SimeonSimeonovIvanov/ROBKO-01/doc/SNS_2009/SNS_2009_ROBKO_Cv_De_Si_04_09_ppt.pdf

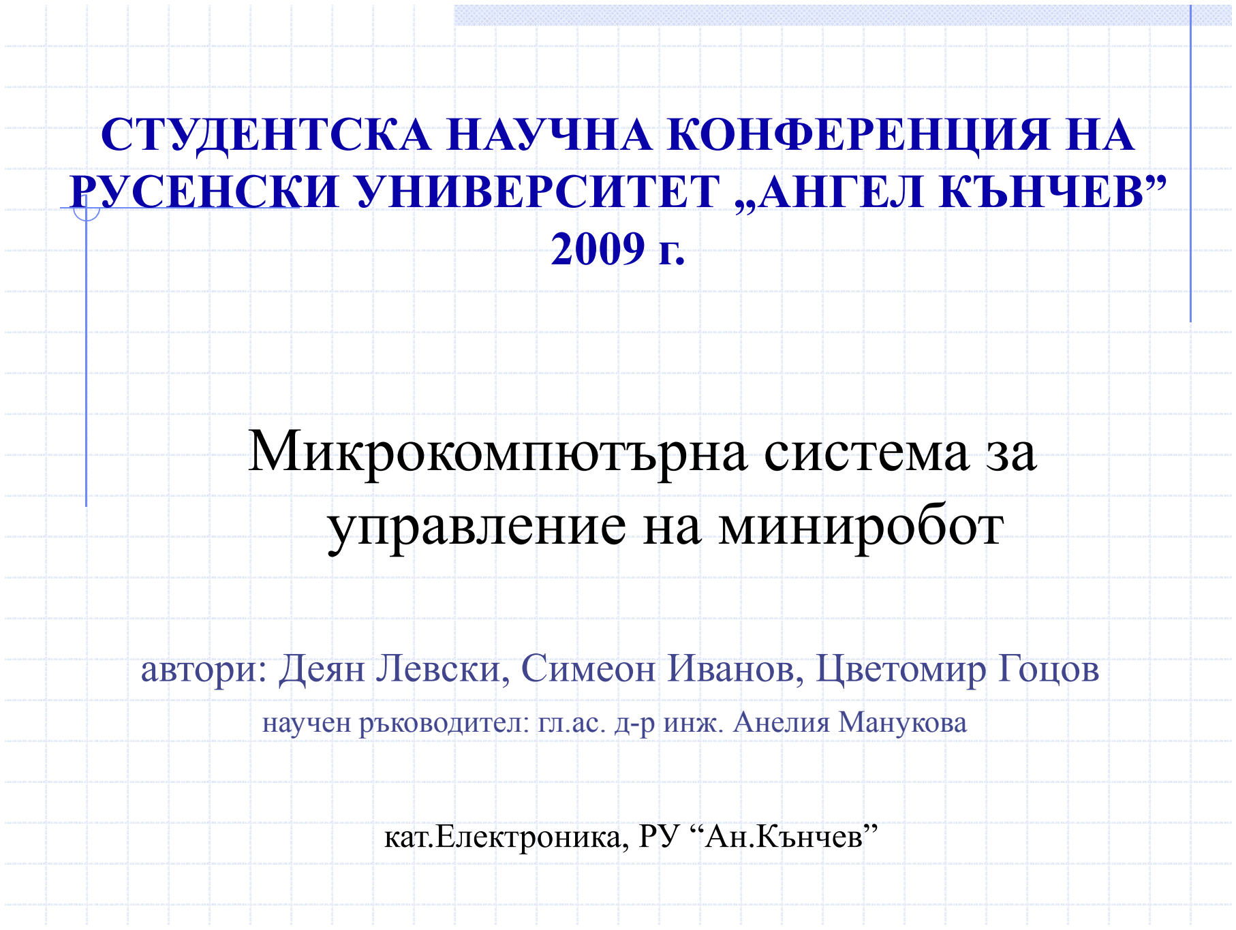
[picture p27: figure]
Микрокомпютърна система за управление на миниробот; кат.Електроника, РУ “Ан.Кънчев”; СТУДЕНТСКА НАУЧНА КОНФЕРЕНЦИЯ НА РУСЕНСКИ УНИВЕРСИТЕТ „АНГЕЛ КЪНЧЕВ” 2009 г.

## автори: Деян Левски, Симеон Иванов, Цветомир Гоцов

научен ръководител: гл.ас. д-р инж. Анелия Манукова

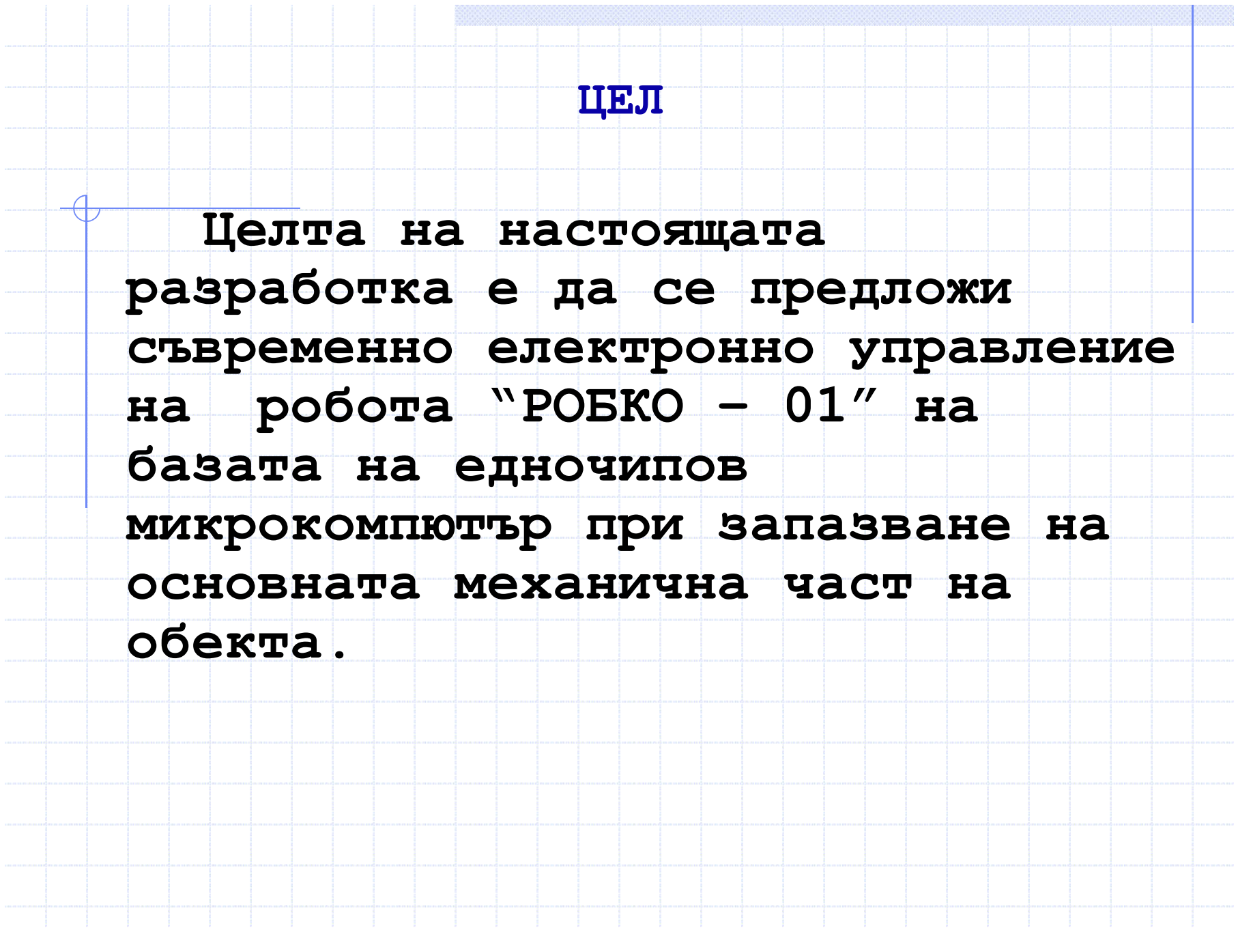
[picture p28: figure]
Целта на настоящата разработка е да се предложи съвременно електронно управление; робота “РОБКО – 01” на; базата на едночипов микрокомпютър при запазване на основната механична част на обекта.; ЦЕЛ

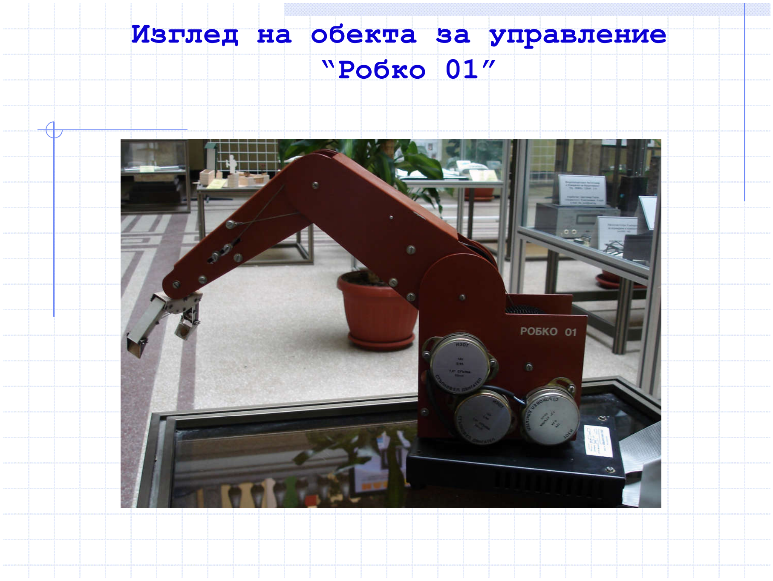
[picture p29: figure]
Изглед на обекта за управление “Робко 01”

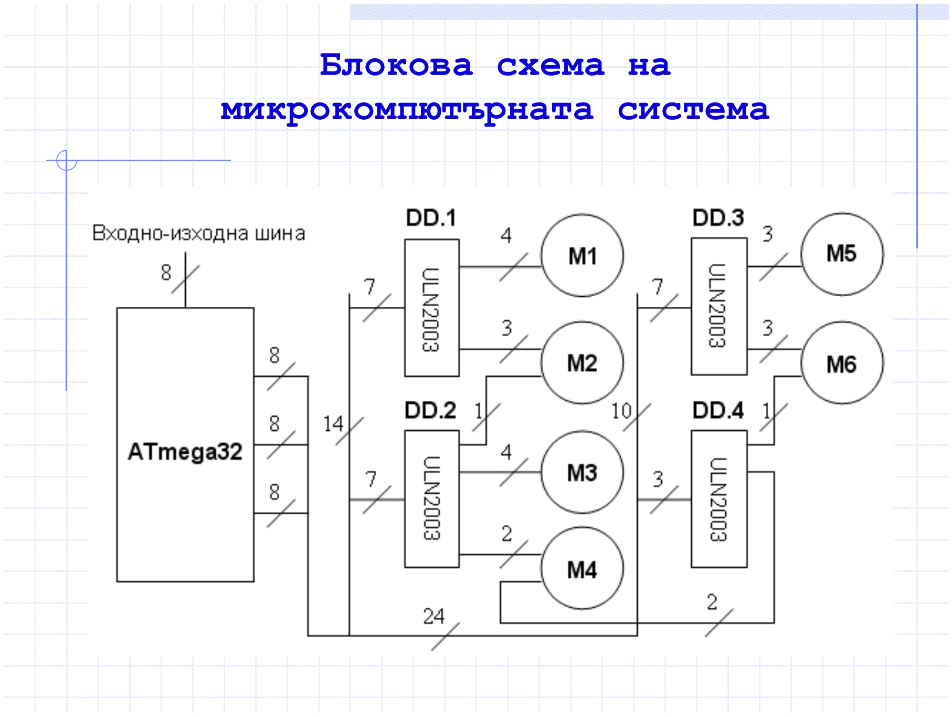
[picture p30: figure]
Блокова схема на микрокомпютърната система

## Алгоритъм за управление на

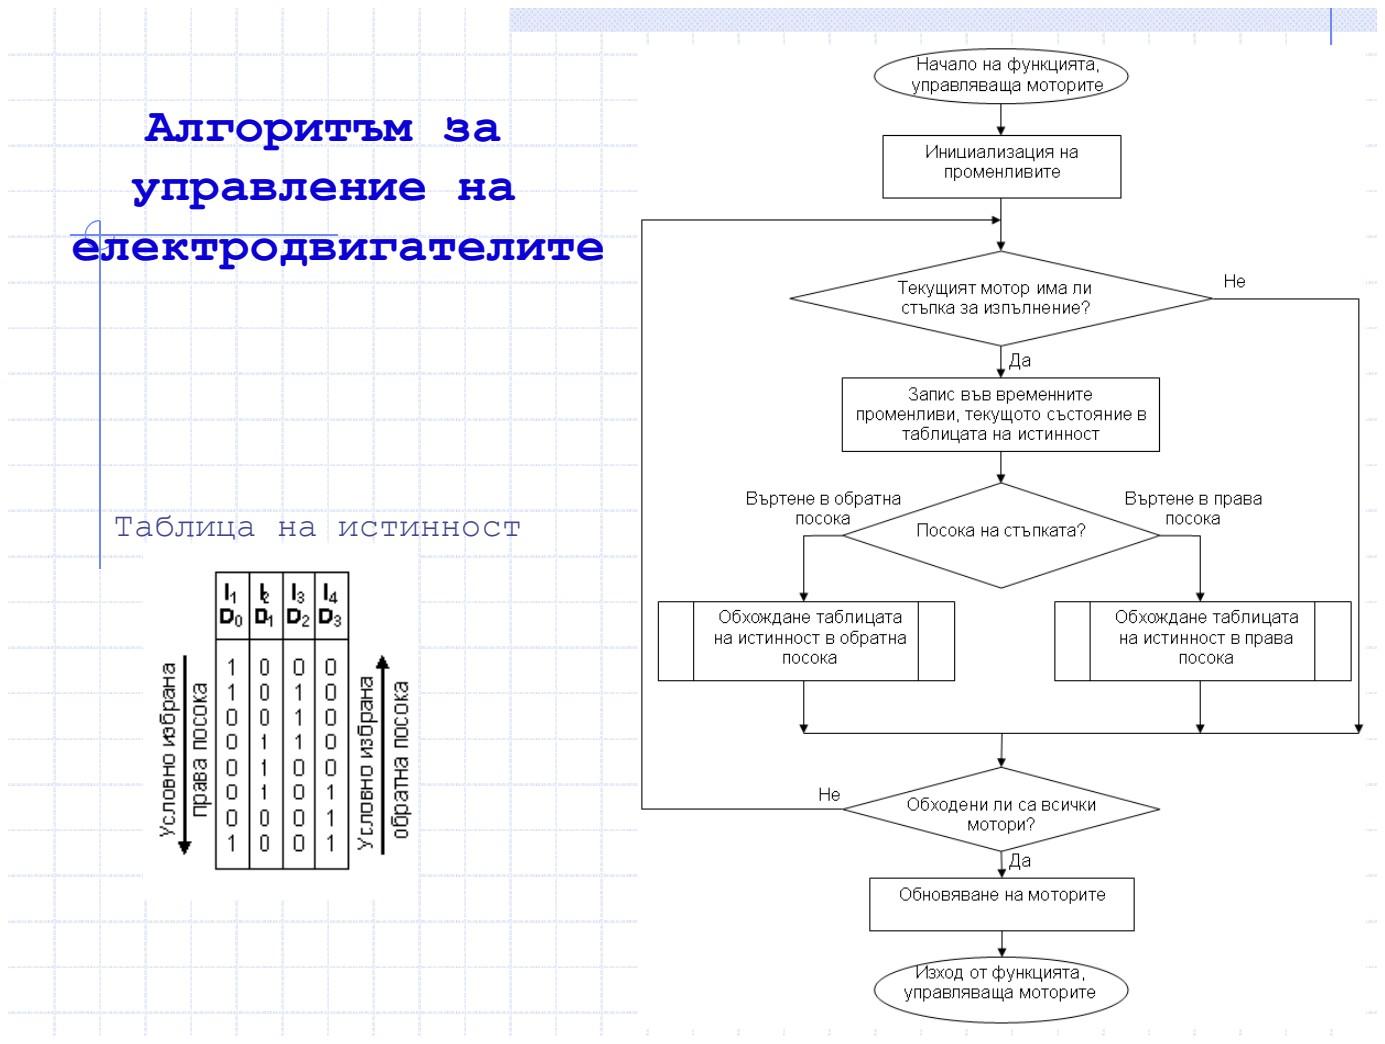
[picture p31: page 5]

## електродвигателите

Таблица на истинност

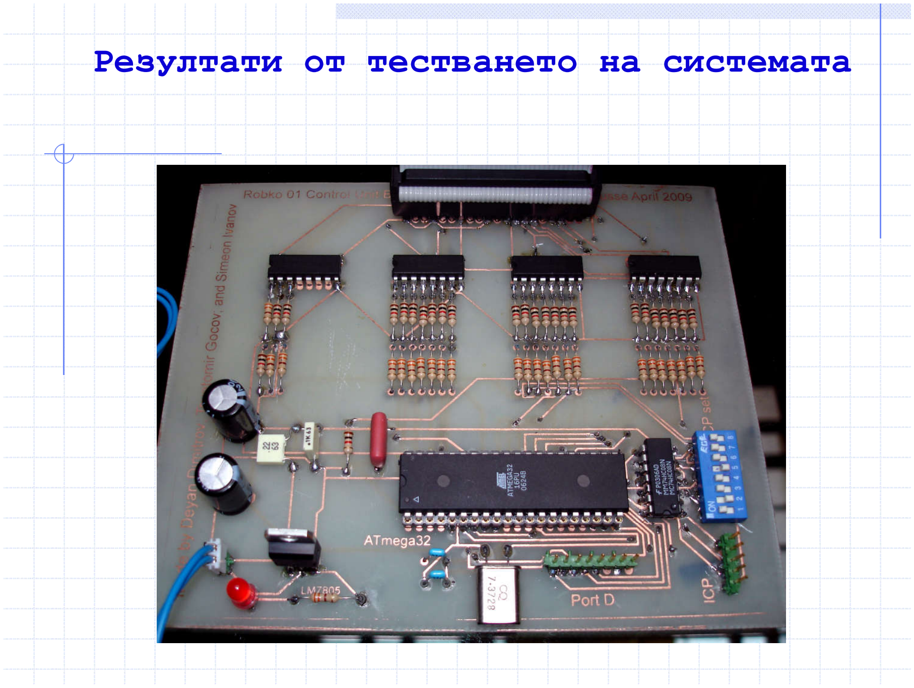
[picture p32: figure]
Резултати от тестването на системата

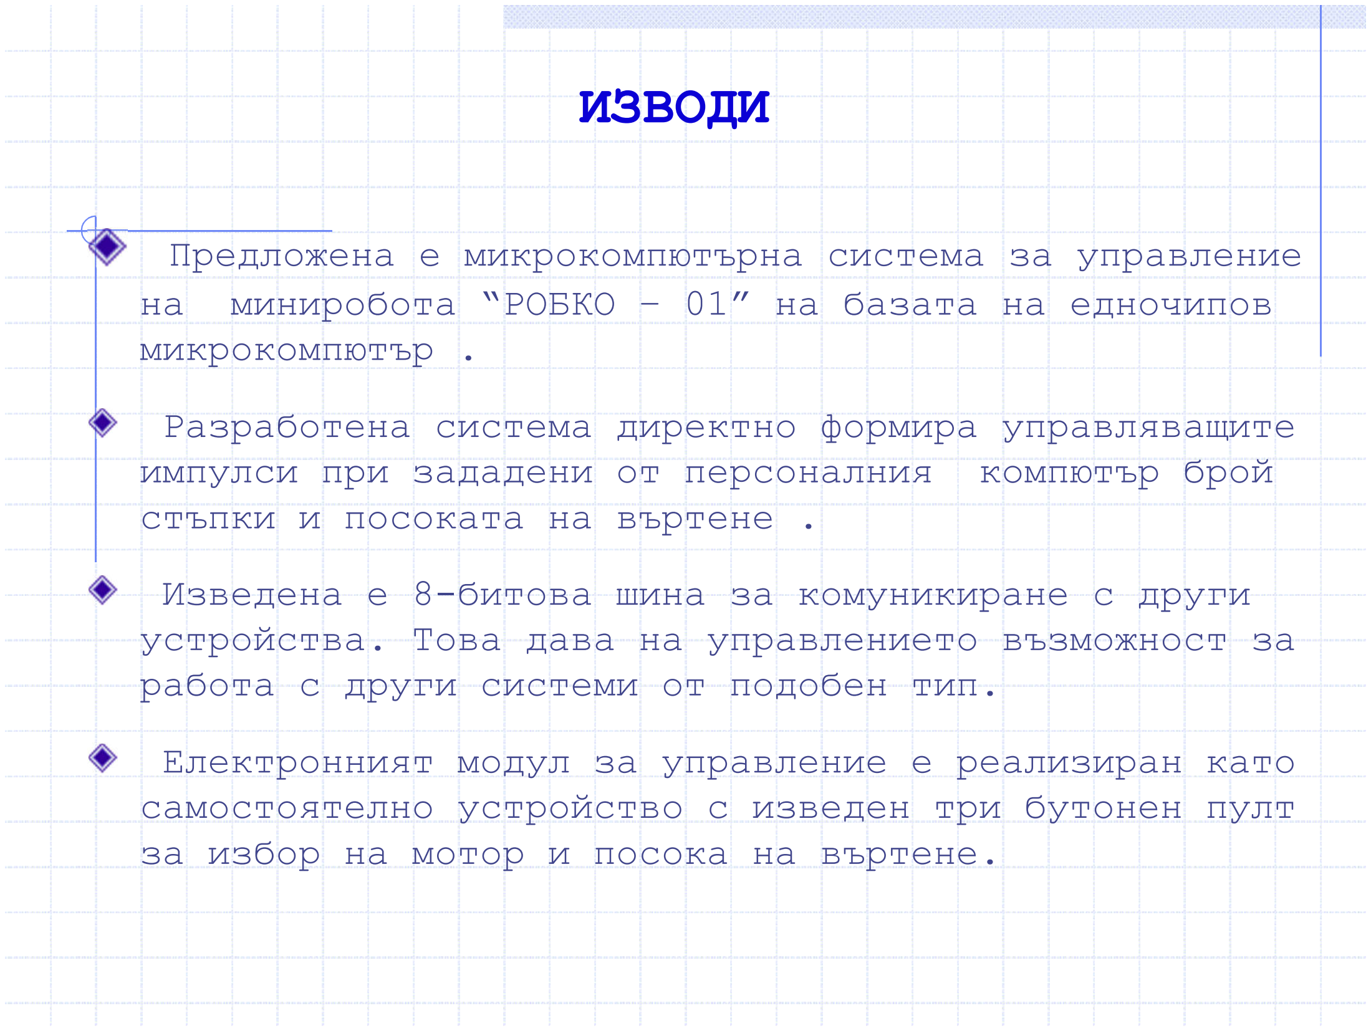
[picture p33: figure]
микрокомпютър .; Разработена система директно формира управляващите; импулси при зададени от персоналния; компютър брой; стъпки и посоката на въртене .; работа с други системи от подобен тип.; за избор на мотор и посока на въртене.; ИЗВОДИ

Предложена е микрокомпютърна система за управление на миниробота “РОБКО – 01” на базата на едночипов

Изведена е 8-битова шина за комуникиране с други устройства. Това дава на управлението възможност за

Електронният модул за управление е реализиран като самостоятелно устройство с изведен три бутонен пулт

Бъдещата работа по микрокомпютърната система е насочена към въвеждане на обратна връзка за текущото състояние на обекта - миниробот. Поради амортизация на механичната част на управлявания обект, процес неизбежен във времето, може да се натрупа значителна грешка в движението на ставите на робота.

Предложената система може да се усъвършенства като се добавят ротационни енкодери на валовете на електродвигателите. От получената информация в микроконтролера за текущото състояние на механичната система ще се изработва необходимата корекция за компенсиране на натрупаната грешка.

## БЪДЕЩА РАБОТА

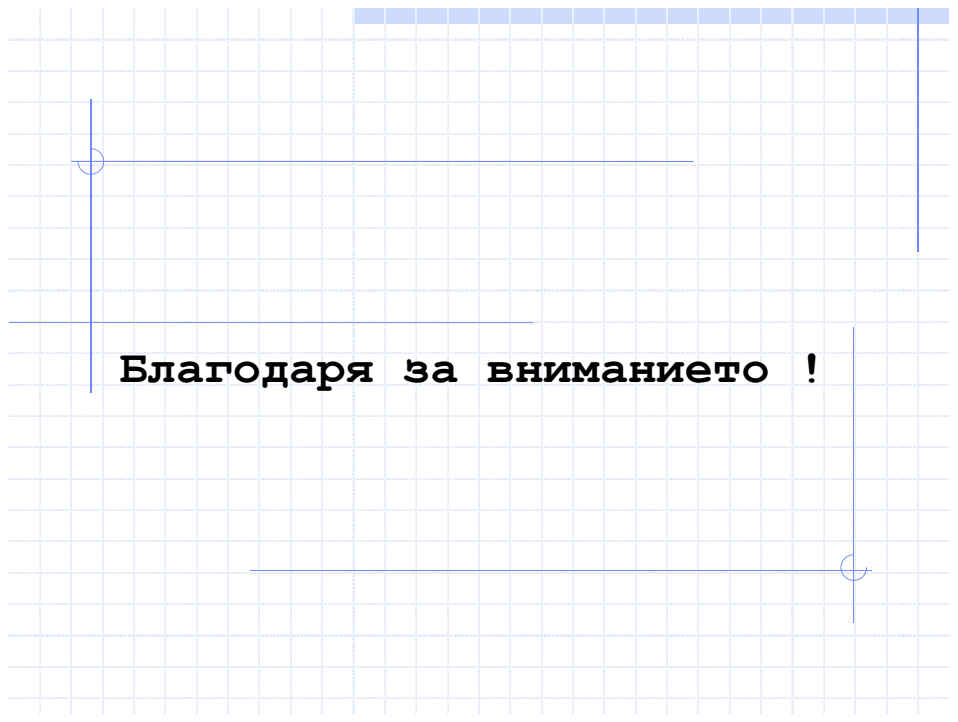
[picture p34: page 9]

Благодаря за вниманието !
