SimeonSimeonovIvanov/ROBKO-01/(list of files, cad)

Other CAD files:
src/SNS_2009/cvAvreval/main.obj
