SimeonSimeonovIvanov/ROBKO-01/doc/mainboard-robko01-150815183218-lva1-app6892.pdf

7 Y6 | 9 Y5 | 10 Y4 | 11 Y3 | 12 Y2 | 13 Y1 | 14 Y0 | 15

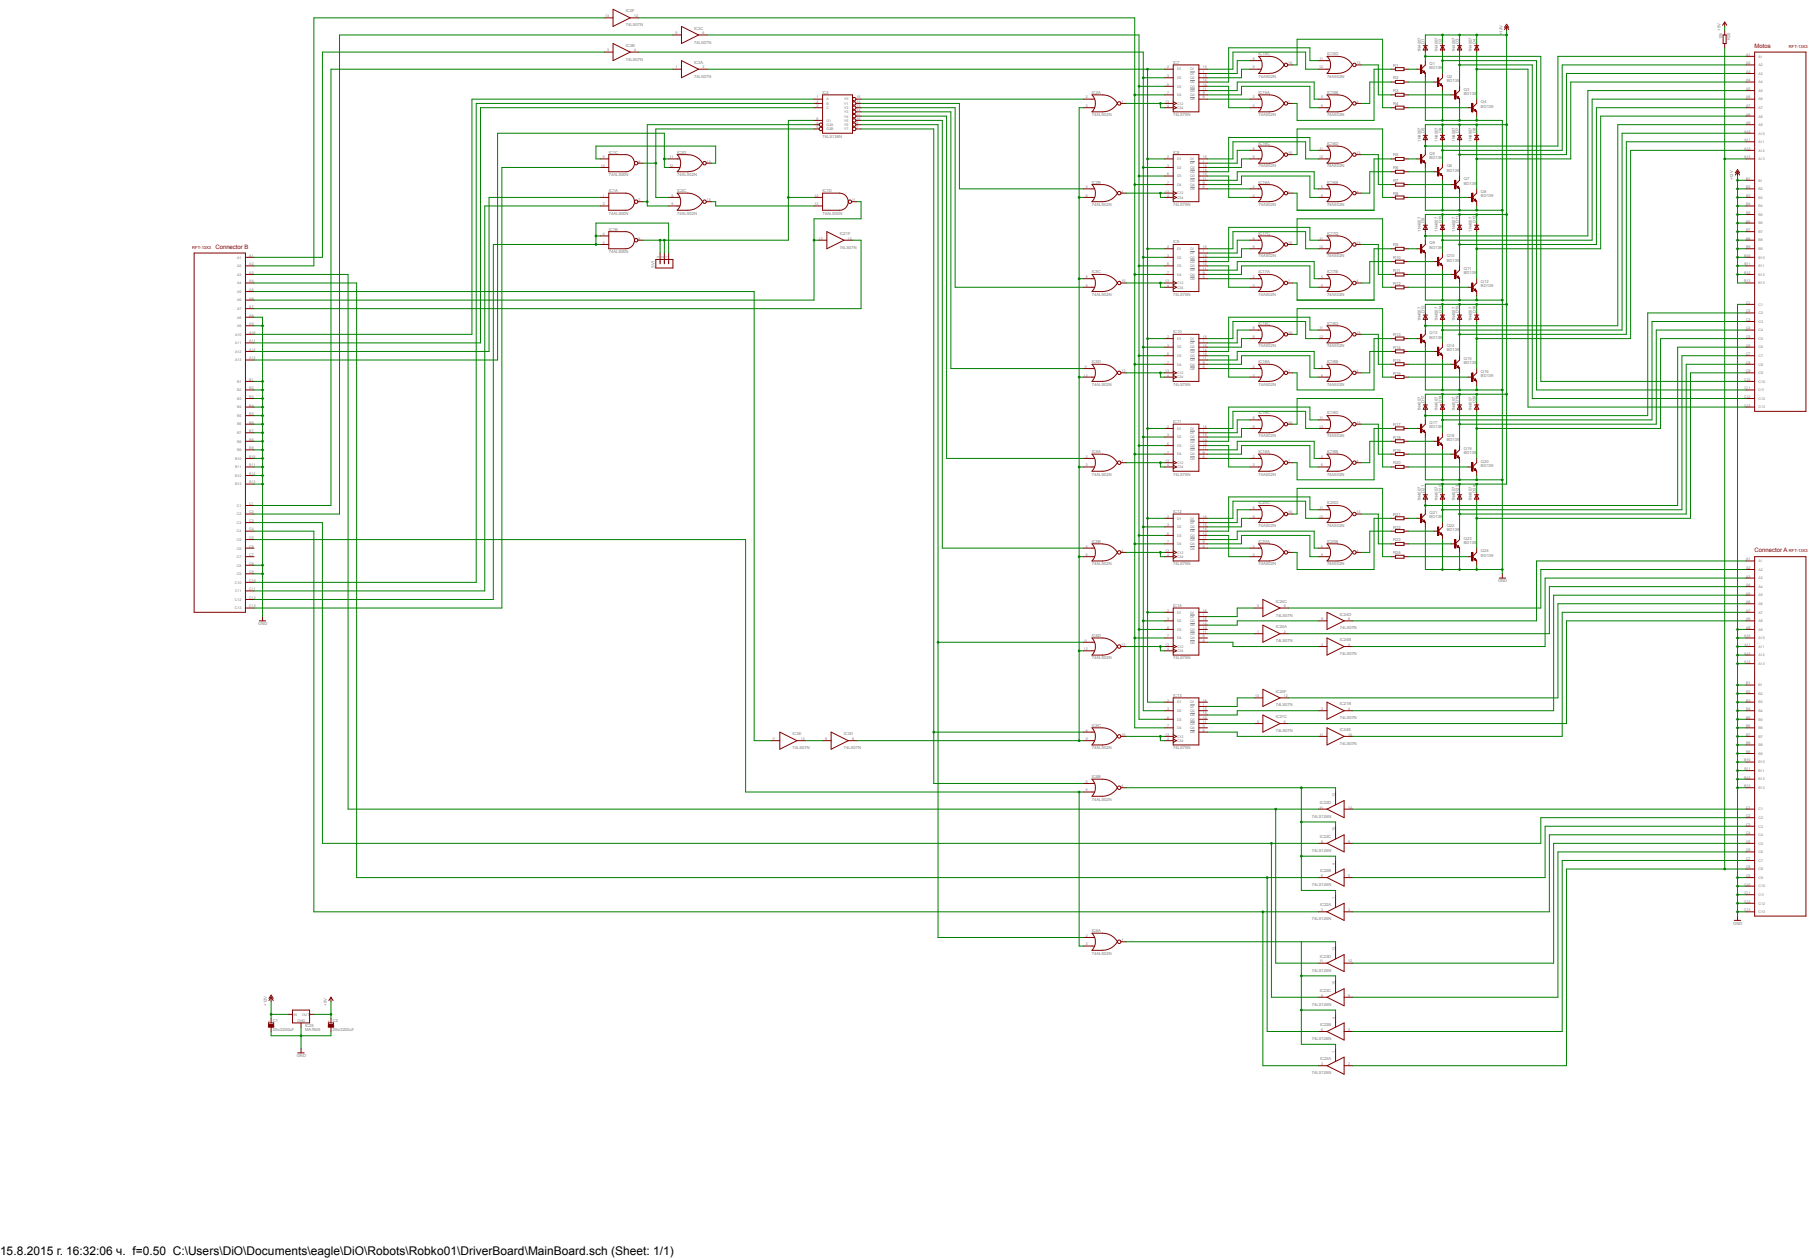
[picture p35: page 1]

15.8.2015 г. 16:32:06 ч. f=0.50 C:\Users\DiO\Documents\eagle\DiO\Robots\Robko01\DriverBoard\MainBoard.sch (Sheet: 1/1)
