SimeonSimeonovIvanov/ROBKO-01/Scheme and Board/v.0.0.1/v.0.0.1 (All Side).pdf

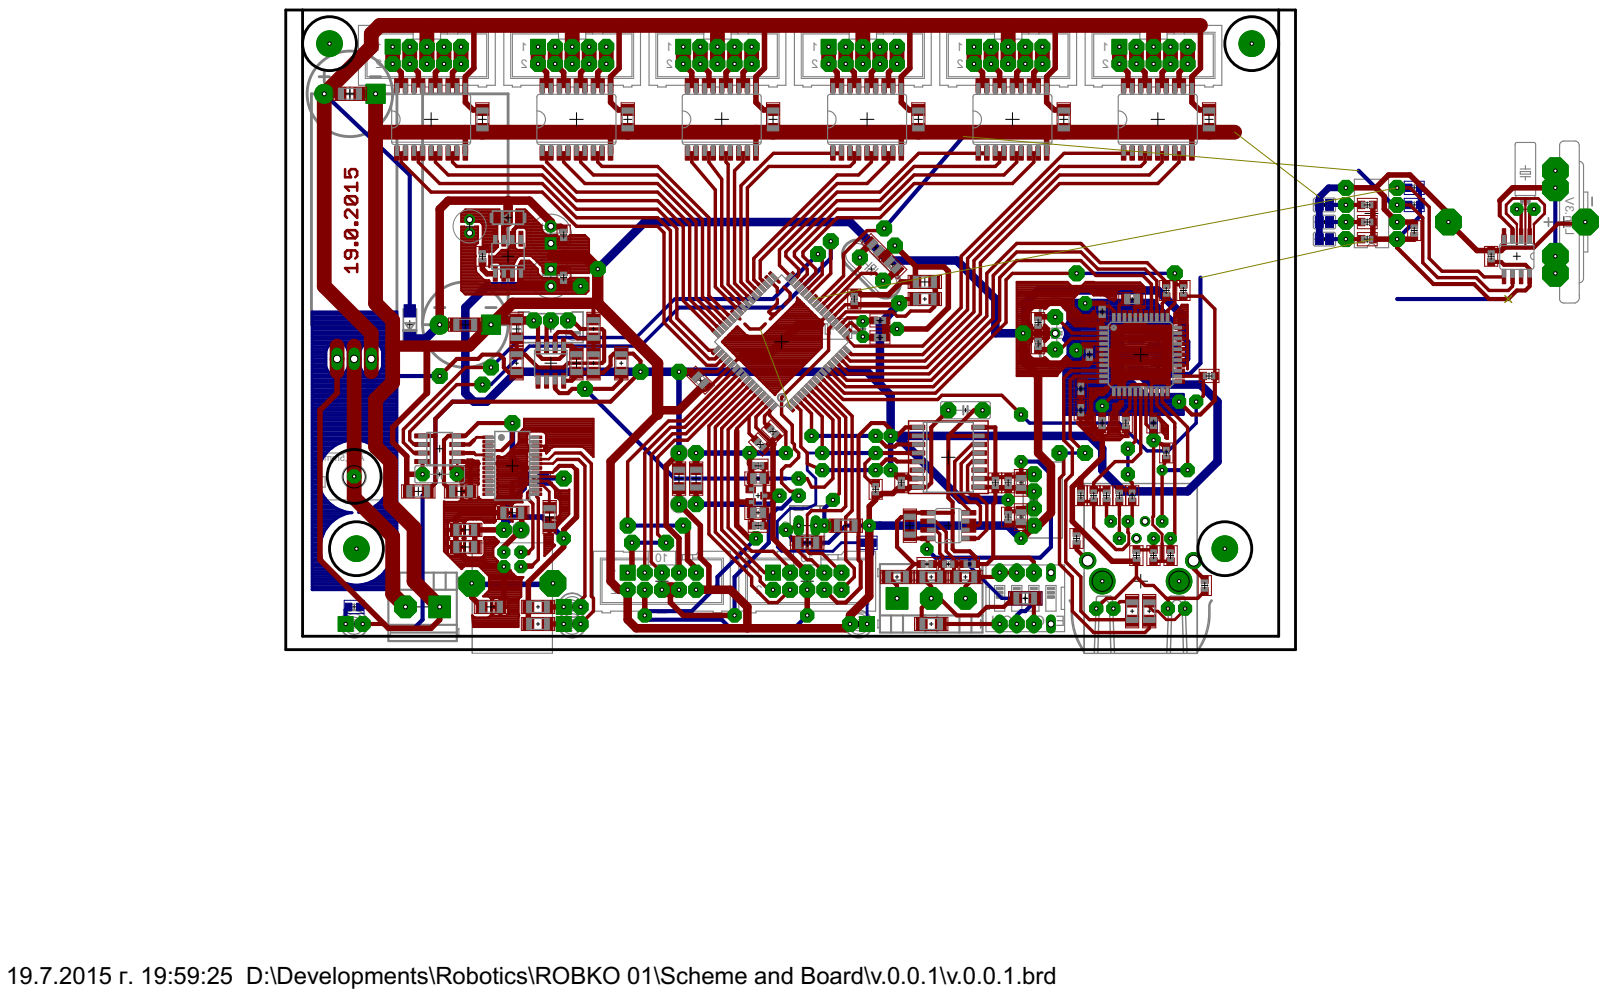
[picture p36: page 1]

19.7.2015 г. 19:59:25 D:\Developments\Robotics\ROBKO 01\Scheme and Board\v.0.0.1\v.0.0.1.brd
