SimeonSimeonovIvanov/ROBKO-01/Scheme and Board/v.0.0.1/v.0.0.1.pdf

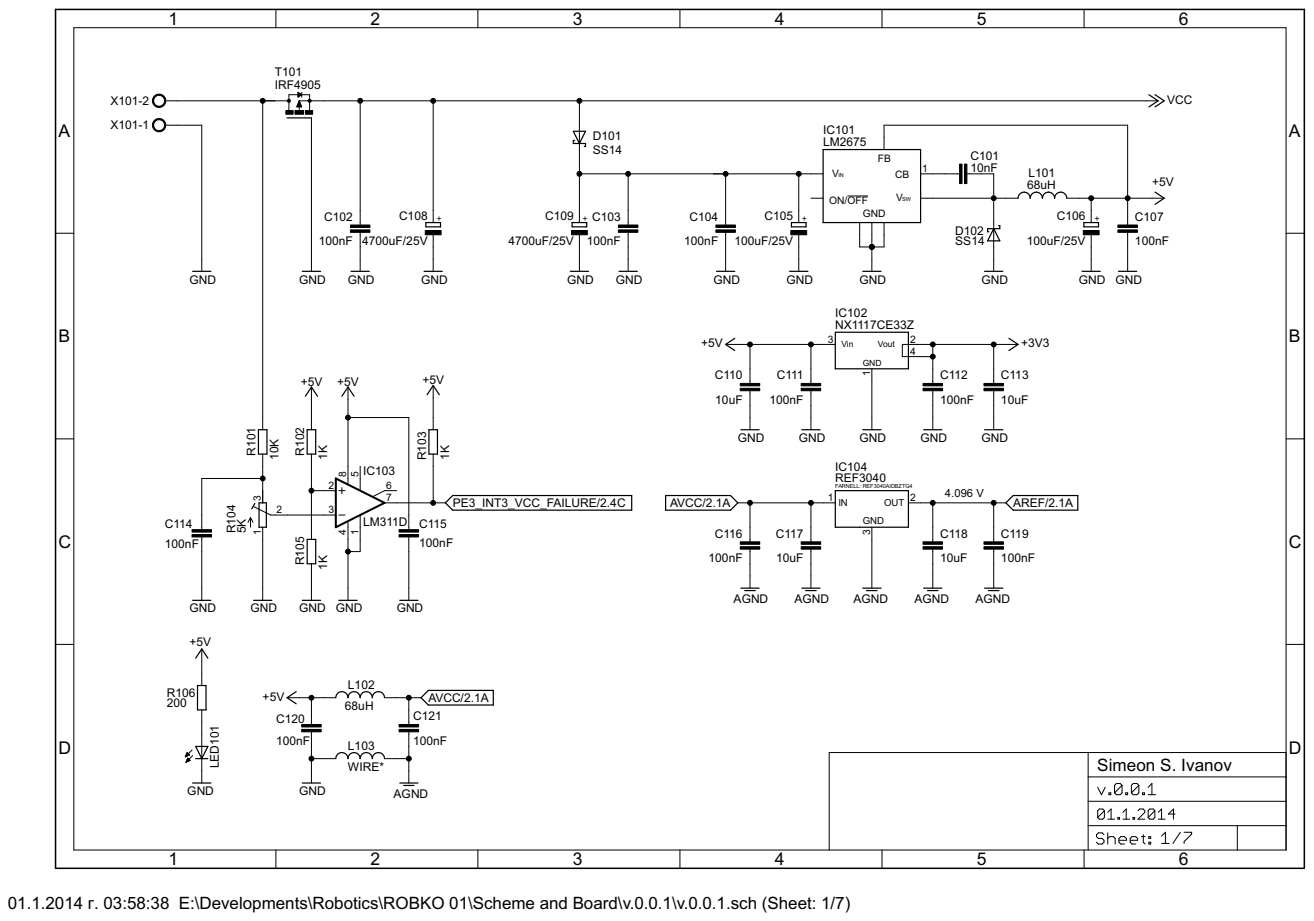
[picture p37: page 1]

01.1.2014 г. 03:58:38 E:\Developments\Robotics\ROBKO 01\Scheme and Board\v.0.0.1\v.0.0.1.sch (Sheet: 1/7)

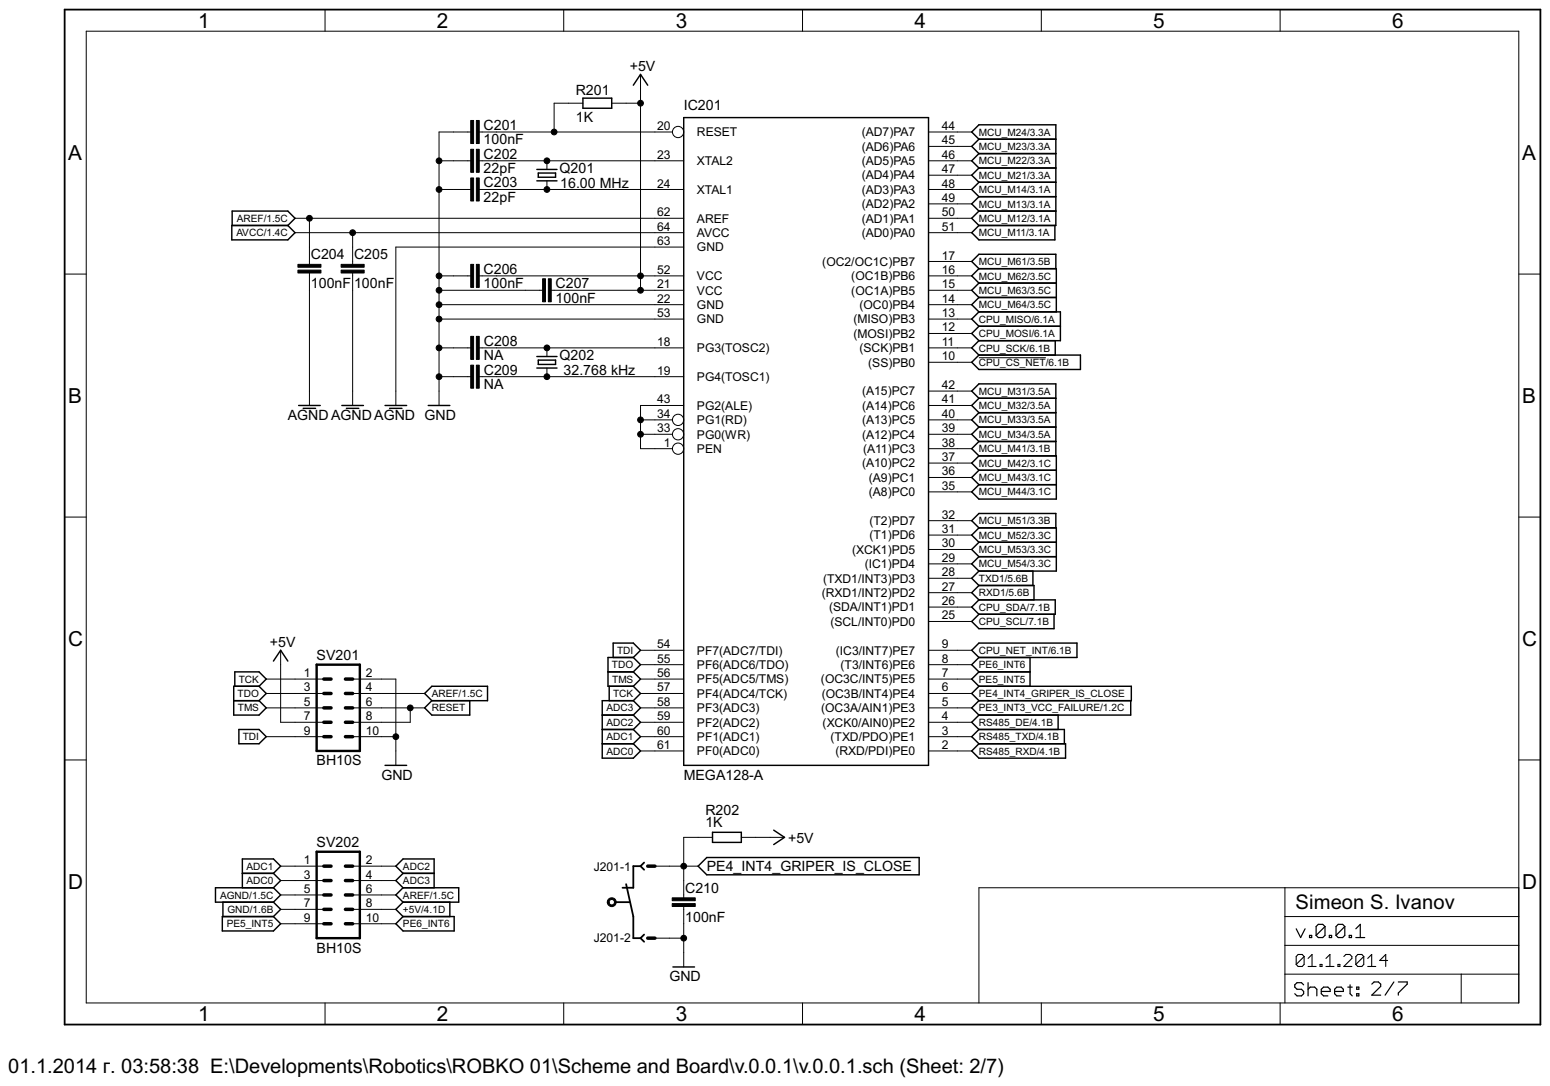
[picture p38: page 2]

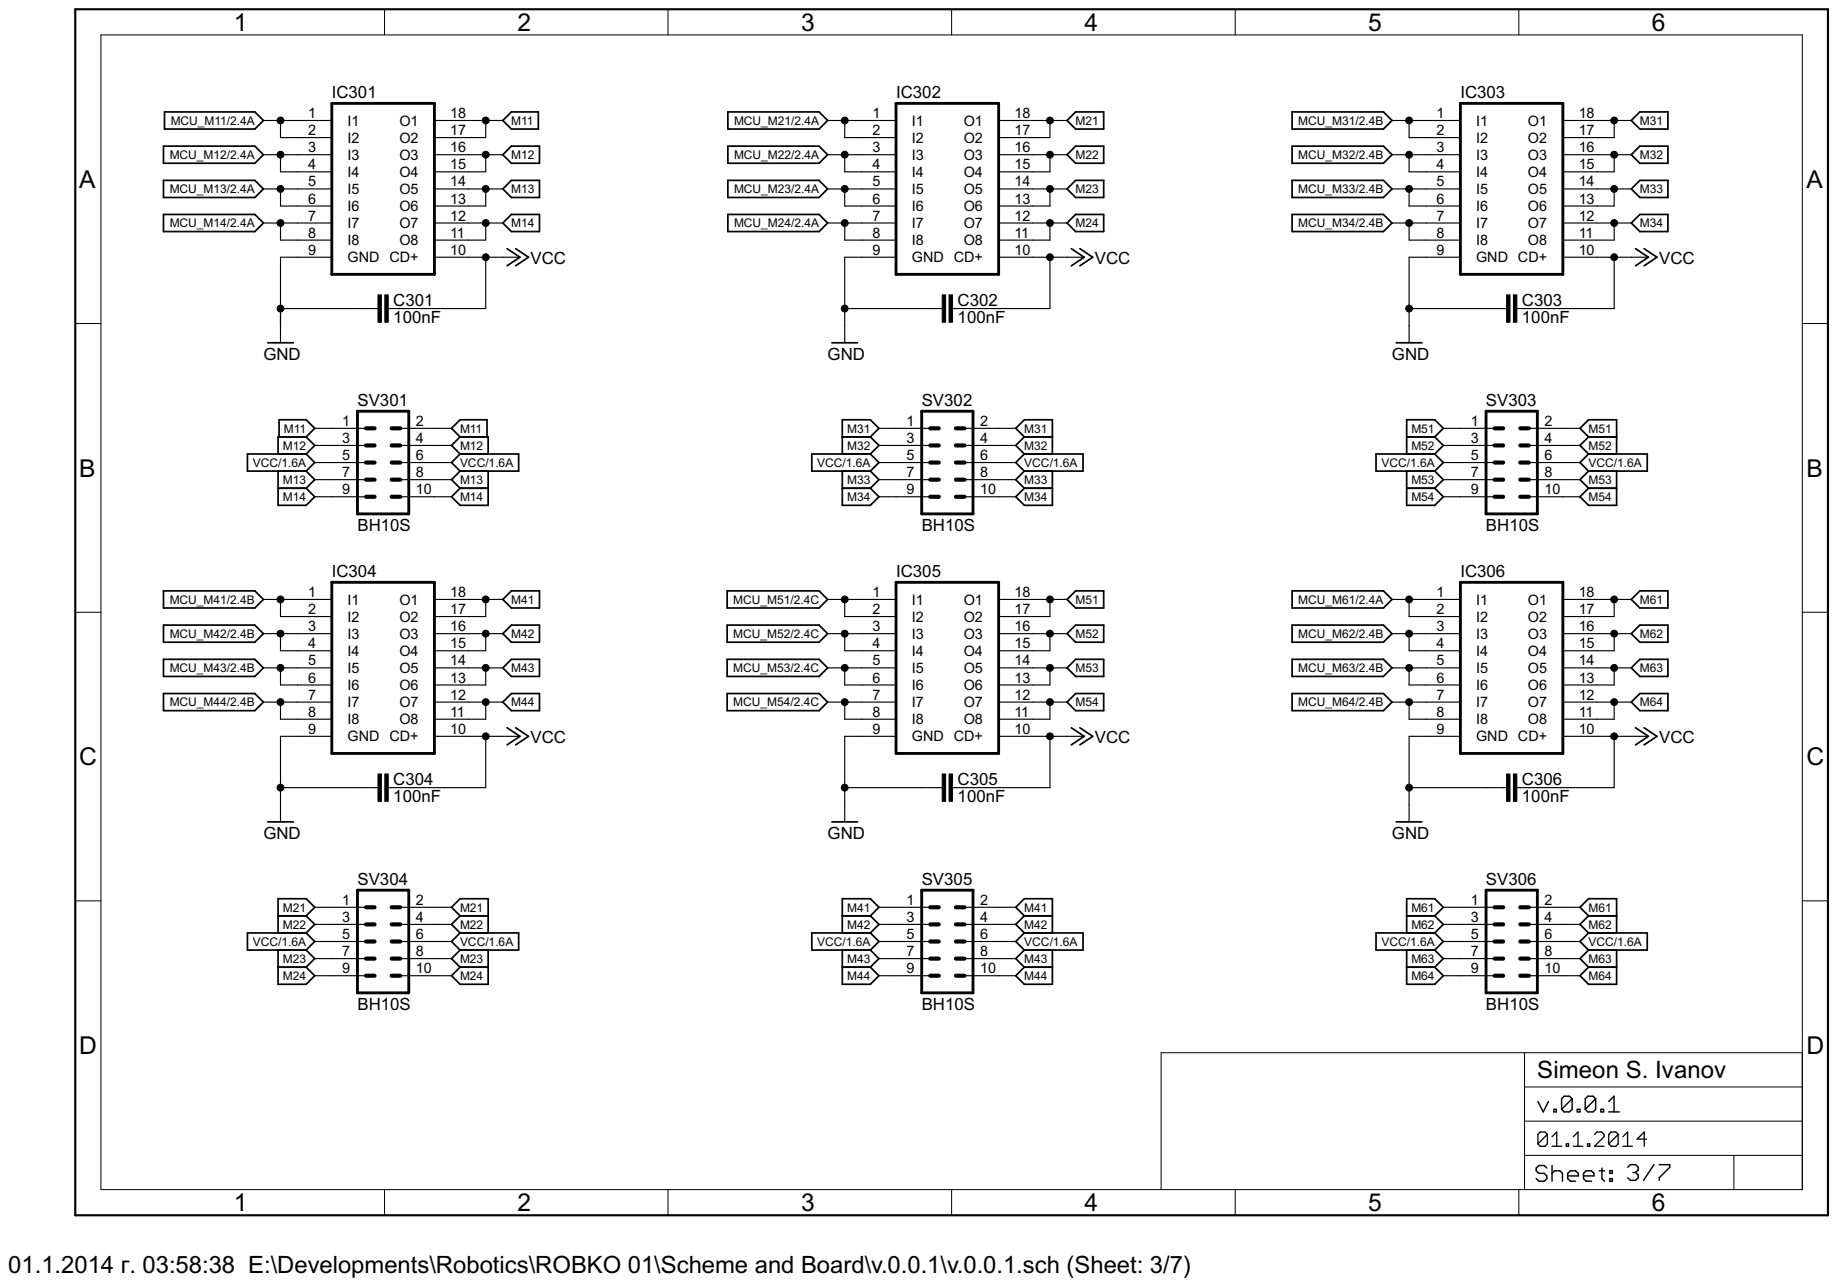
[picture p39: page 3]

01.1.2014 г. 03:58:38 E:\Developments\Robotics\ROBKO 01\Scheme and Board\v.0.0.1\v.0.0.1.sch (Sheet: 3/7)

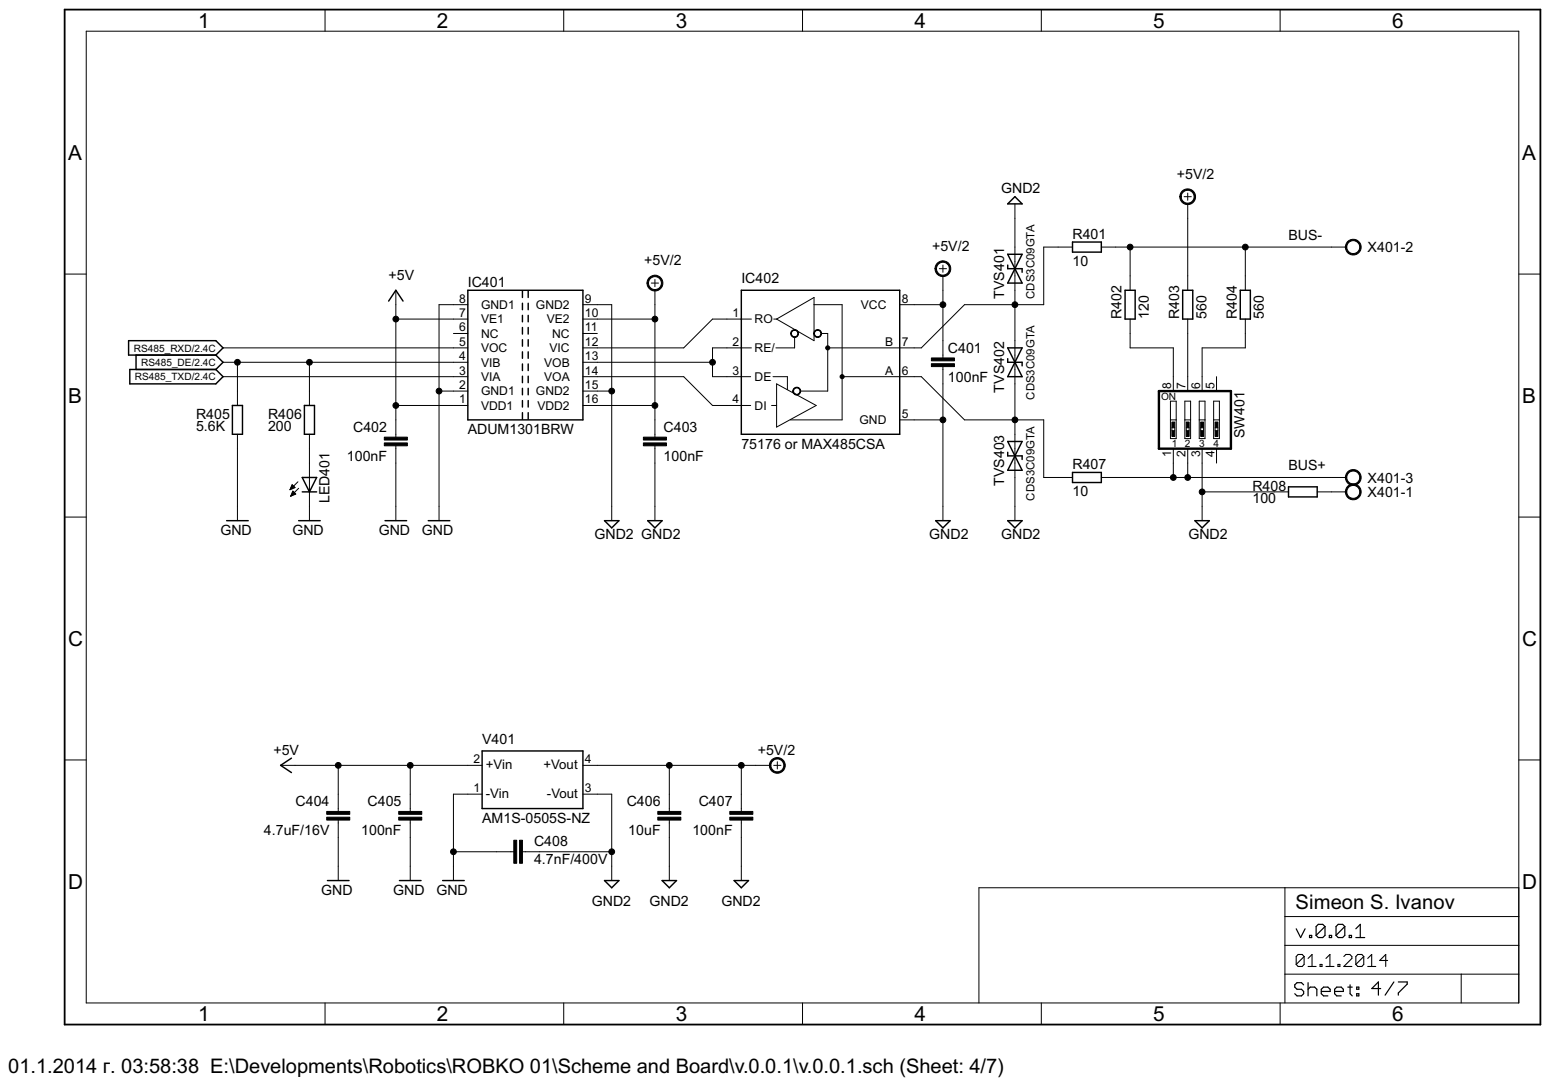
[picture p40: page 4]

01.1.2014 г. 03:58:38 E:\Developments\Robotics\ROBKO 01\Scheme and Board\v.0.0.1\v.0.0.1.sch (Sheet: 4/7)

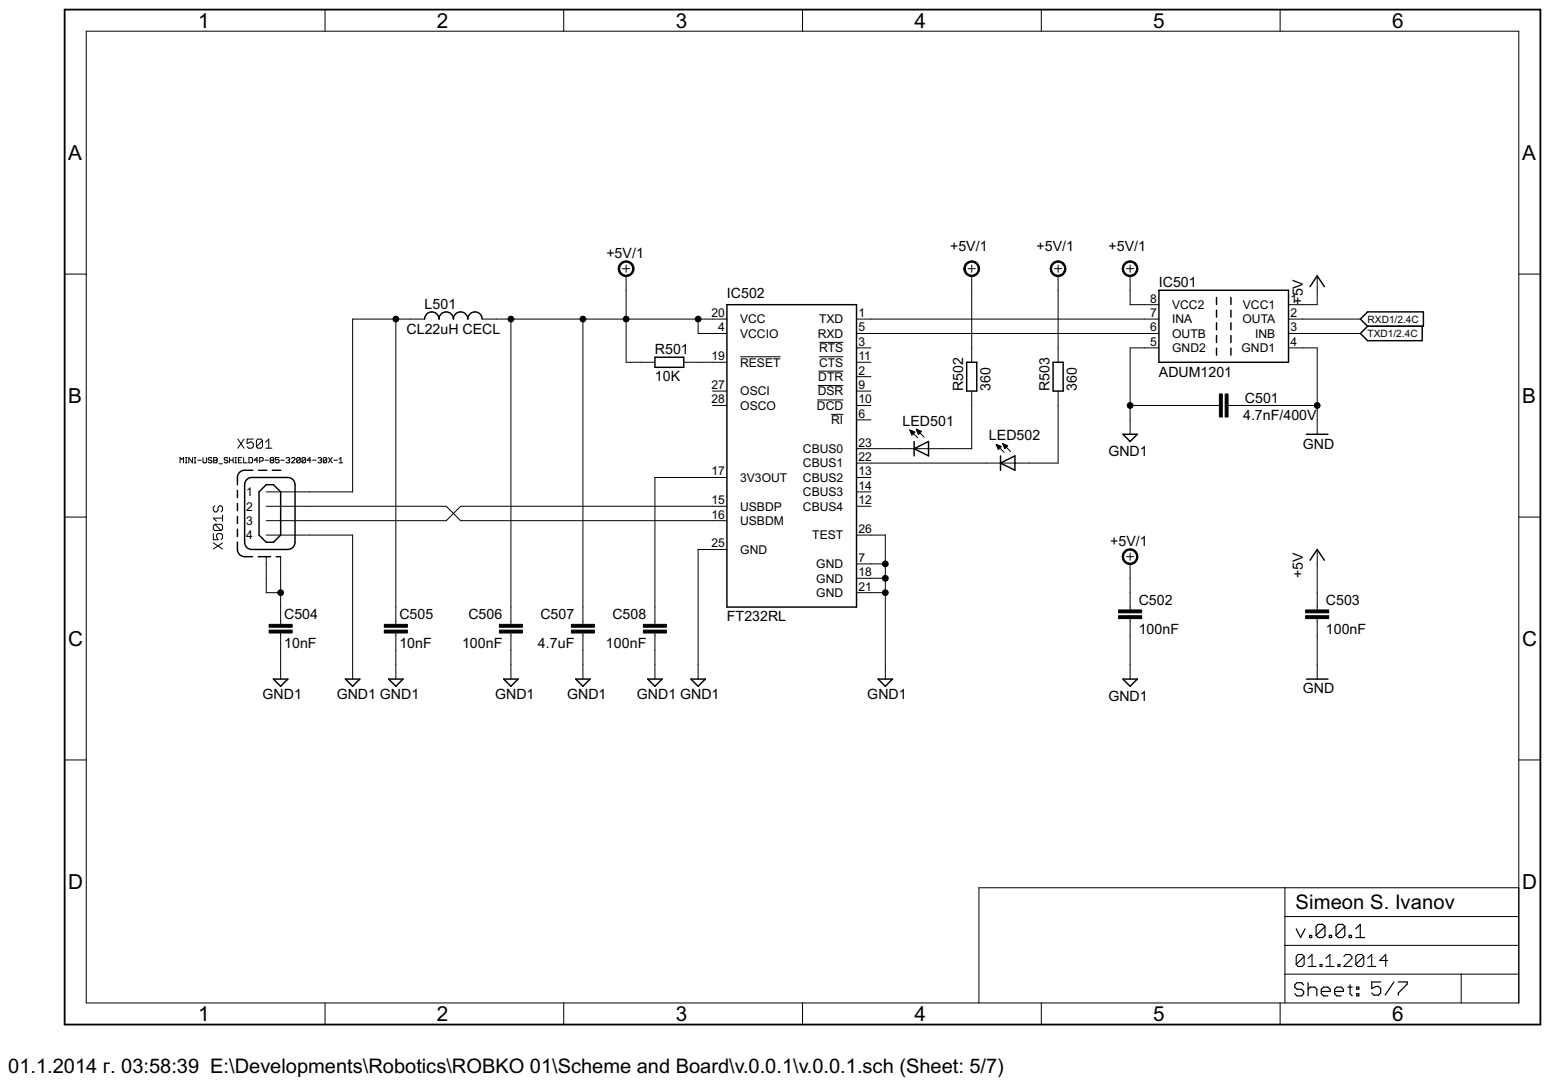
[picture p41: page 5]

01.1.2014 г. 03:58:39 E:\Developments\Robotics\ROBKO 01\Scheme and Board\v.0.0.1\v.0.0.1.sch (Sheet: 5/7)

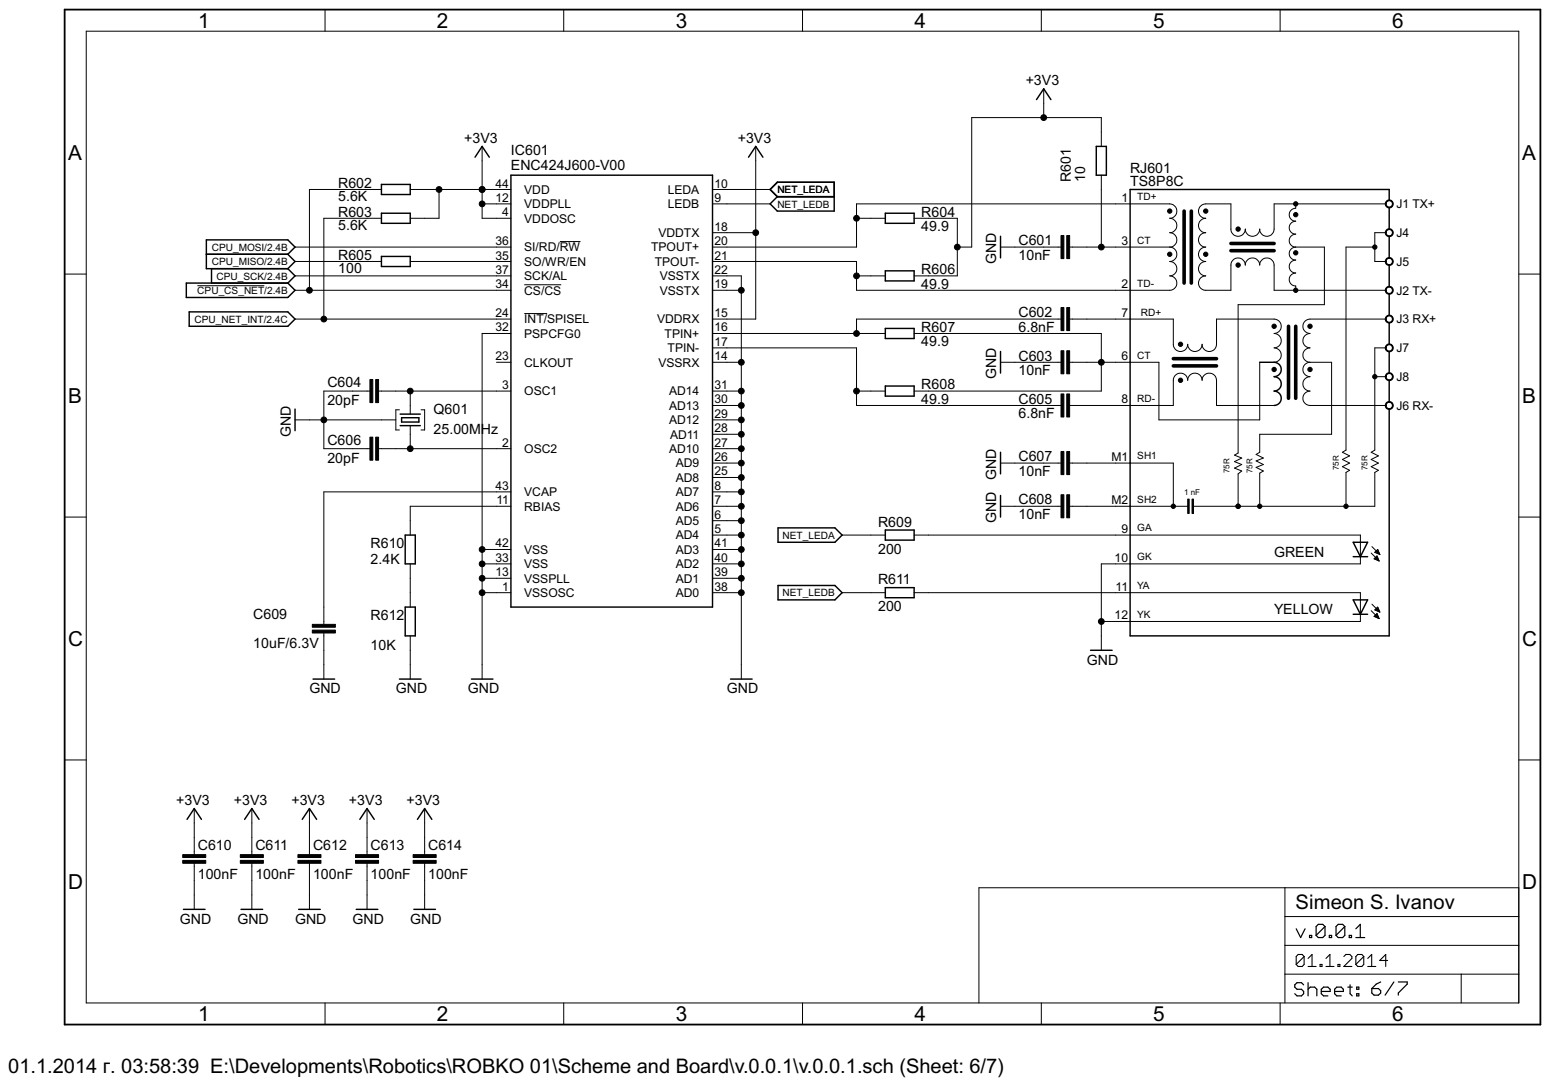
[picture p42: page 6]

01.1.2014 г. 03:58:39 E:\Developments\Robotics\ROBKO 01\Scheme and Board\v.0.0.1\v.0.0.1.sch (Sheet: 6/7)

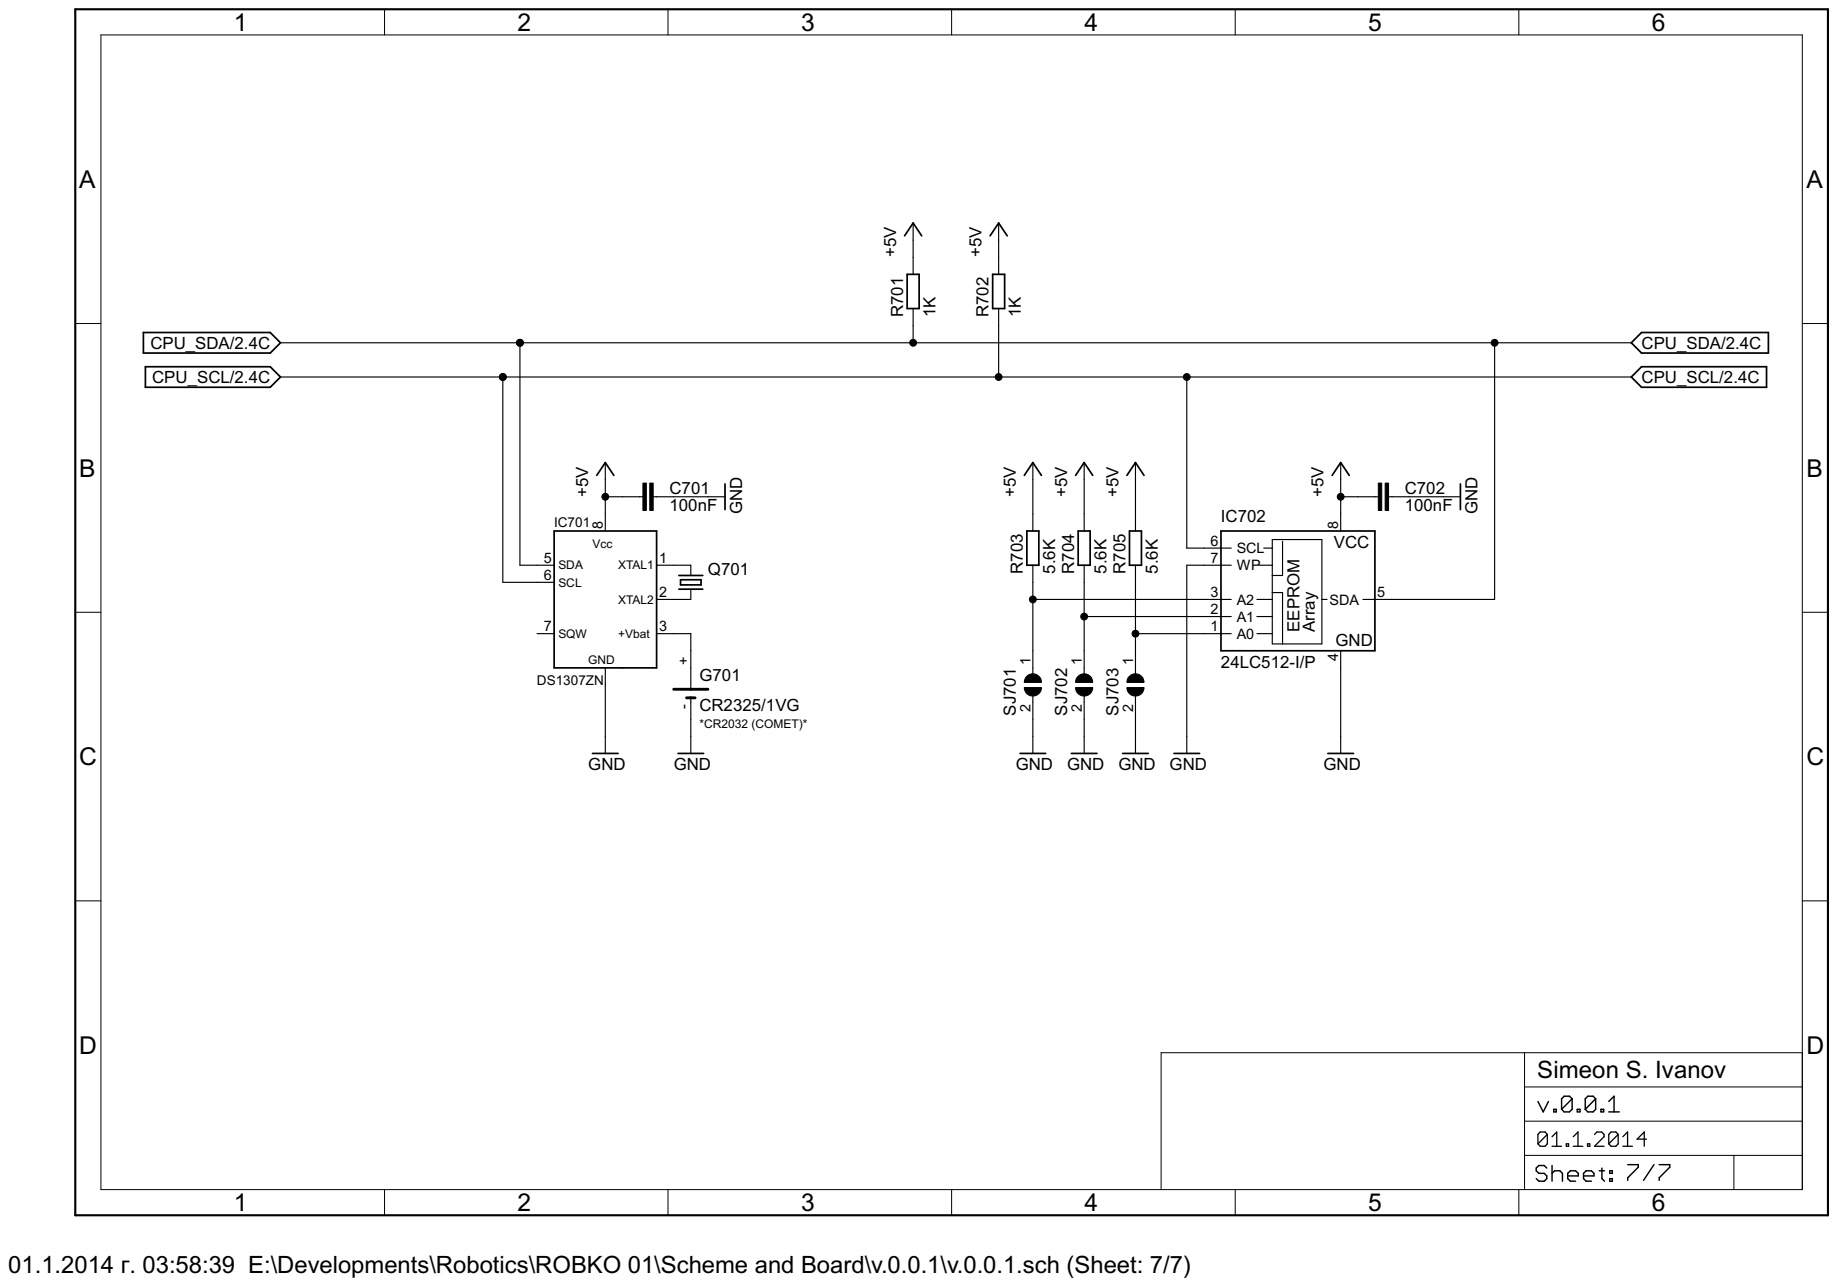
[picture p43: page 7]

01.1.2014 г. 03:58:39 E:\Developments\Robotics\ROBKO 01\Scheme and Board\v.0.0.1\v.0.0.1.sch (Sheet: 7/7)
