SimeonSimeonovIvanov/ROBKO-01/Scheme and Board/CURRENT PWM/v.0.0.1/v.0.0.1 (All Side).pdf

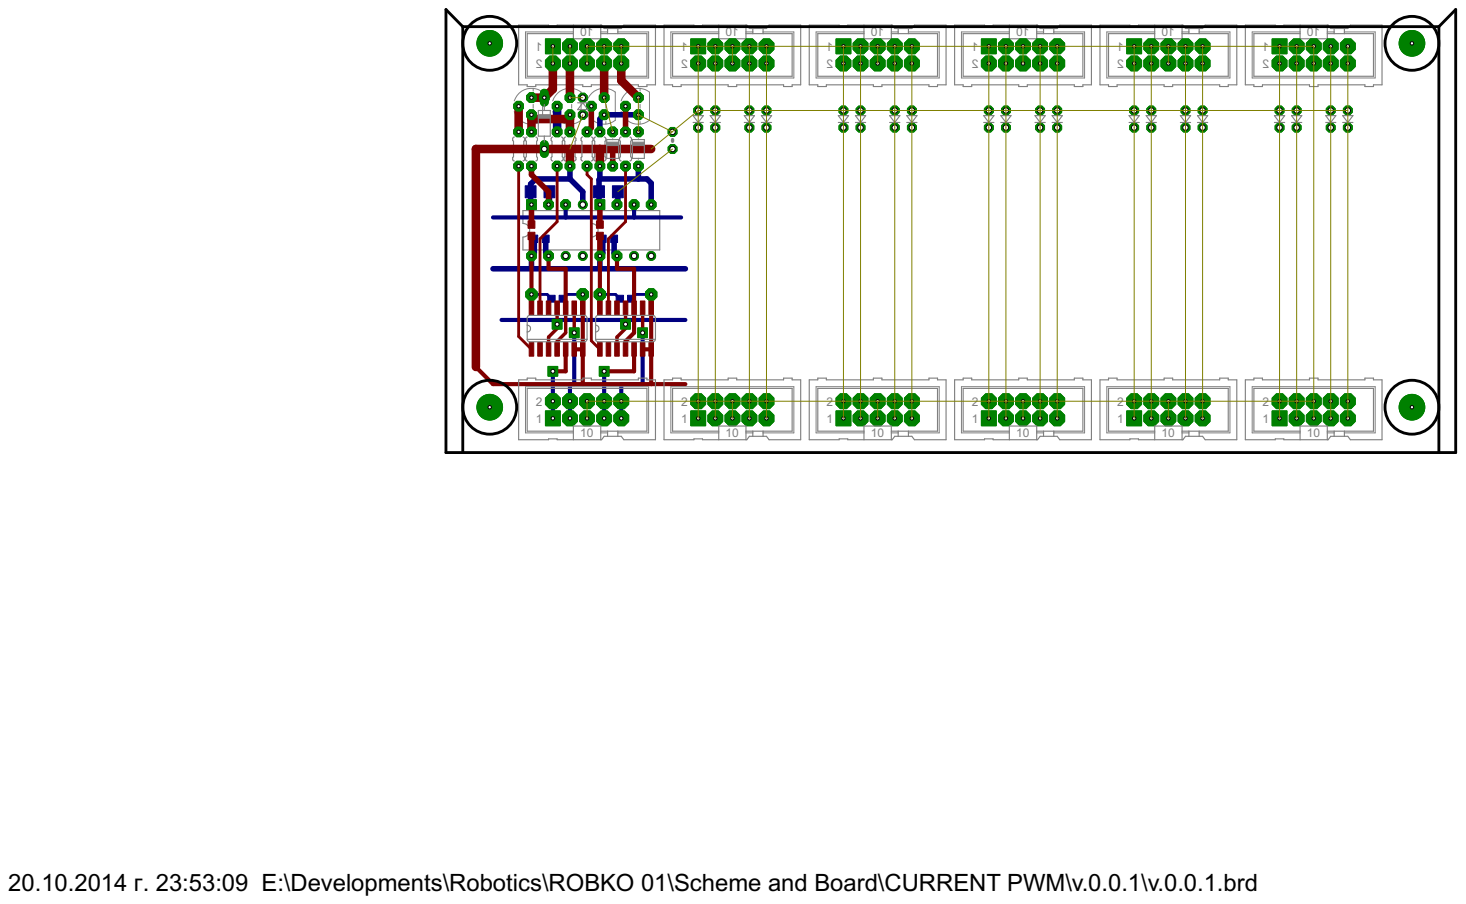
[picture p44: page 1]

20.10.2014 г. 23:53:09 E:\Developments\Robotics\ROBKO 01\Scheme and Board\CURRENT PWM\v.0.0.1\v.0.0.1.brd
