SimeonSimeonovIvanov/ROBKO-01/Scheme and Board/CURRENT PWM/v.0.0.1/v.0.0.1.pdf

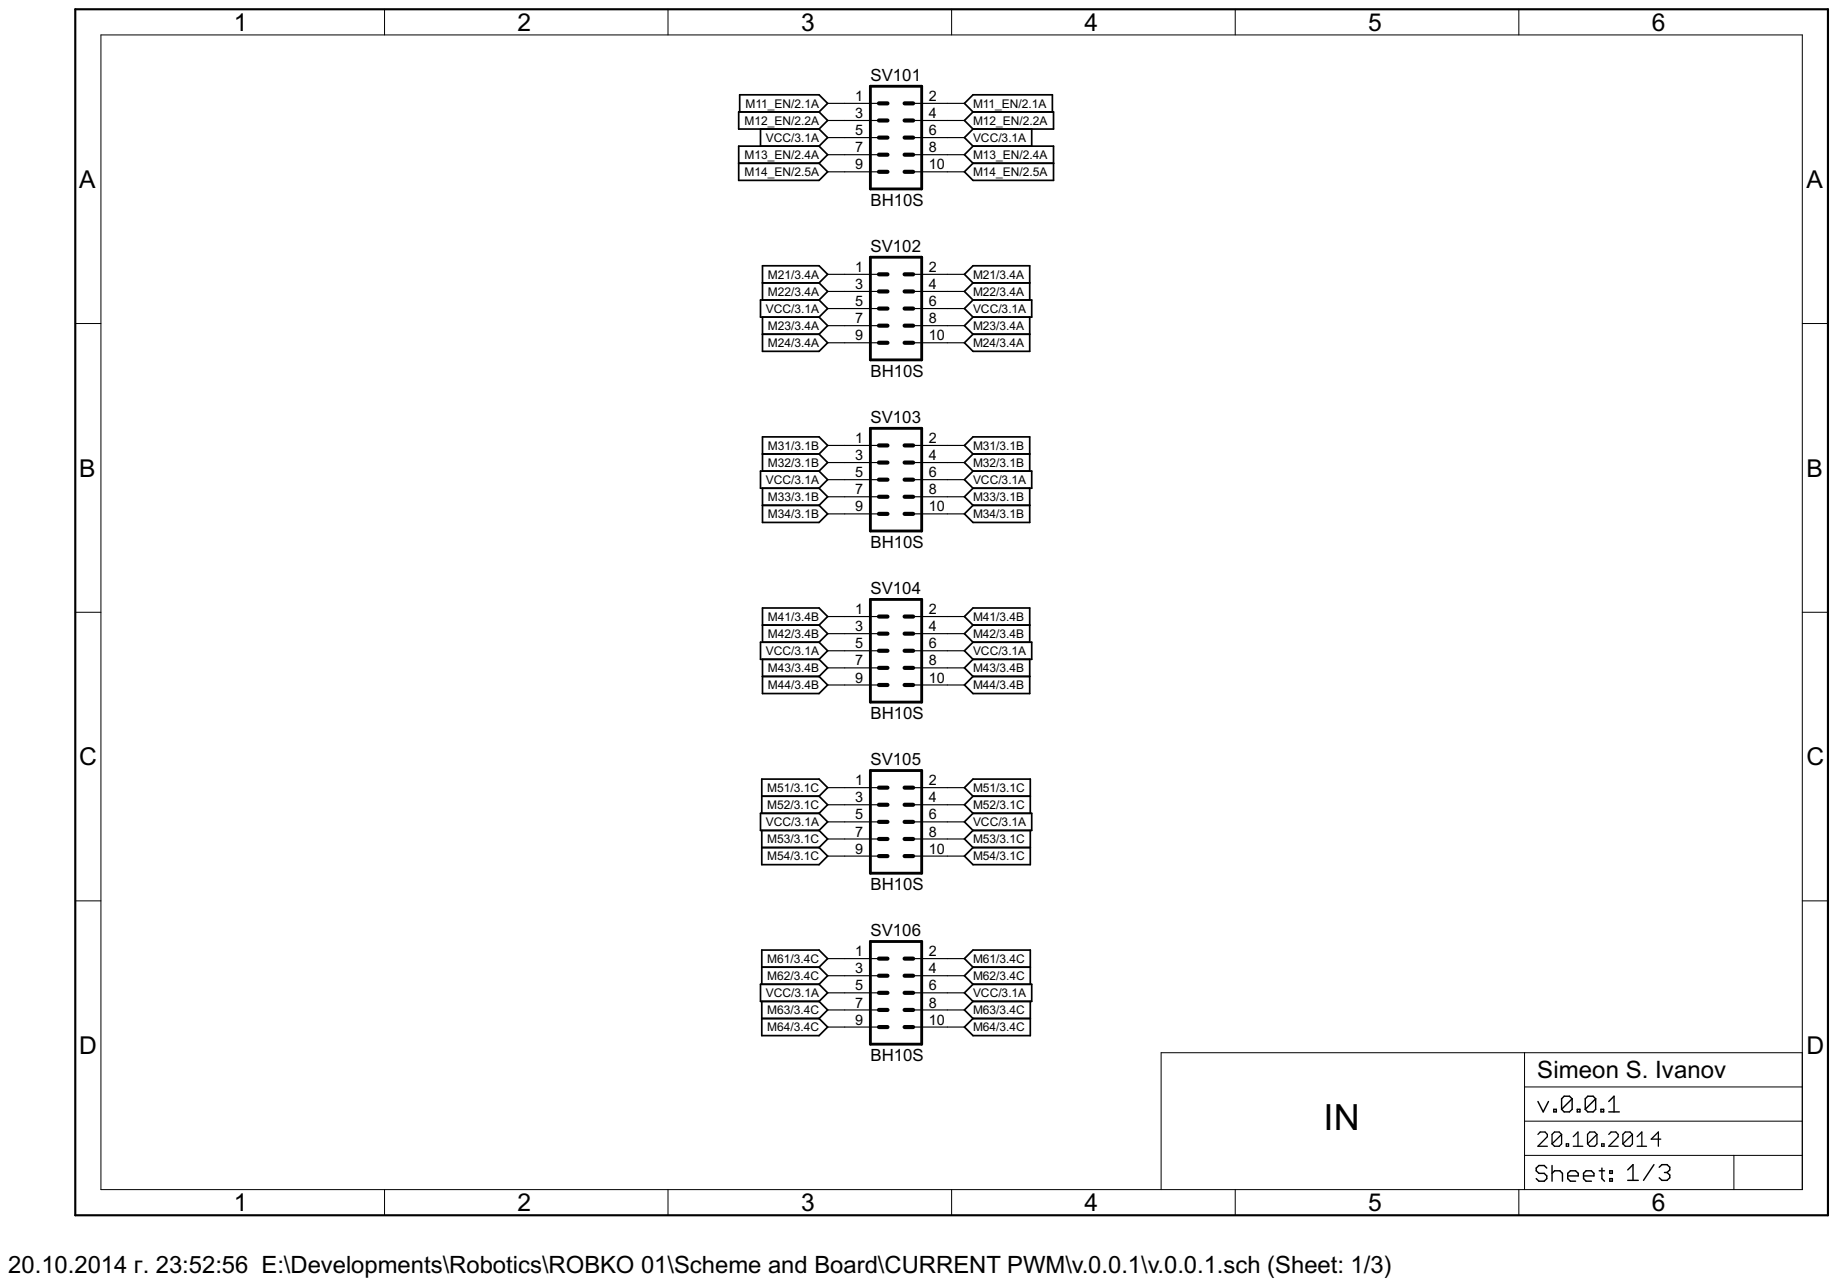
[picture p45: page 1]

20.10.2014 г. 23:52:56 E:\Developments\Robotics\ROBKO 01\Scheme and Board\CURRENT PWM\v.0.0.1\v.0.0.1.sch (Sheet: 1/3)

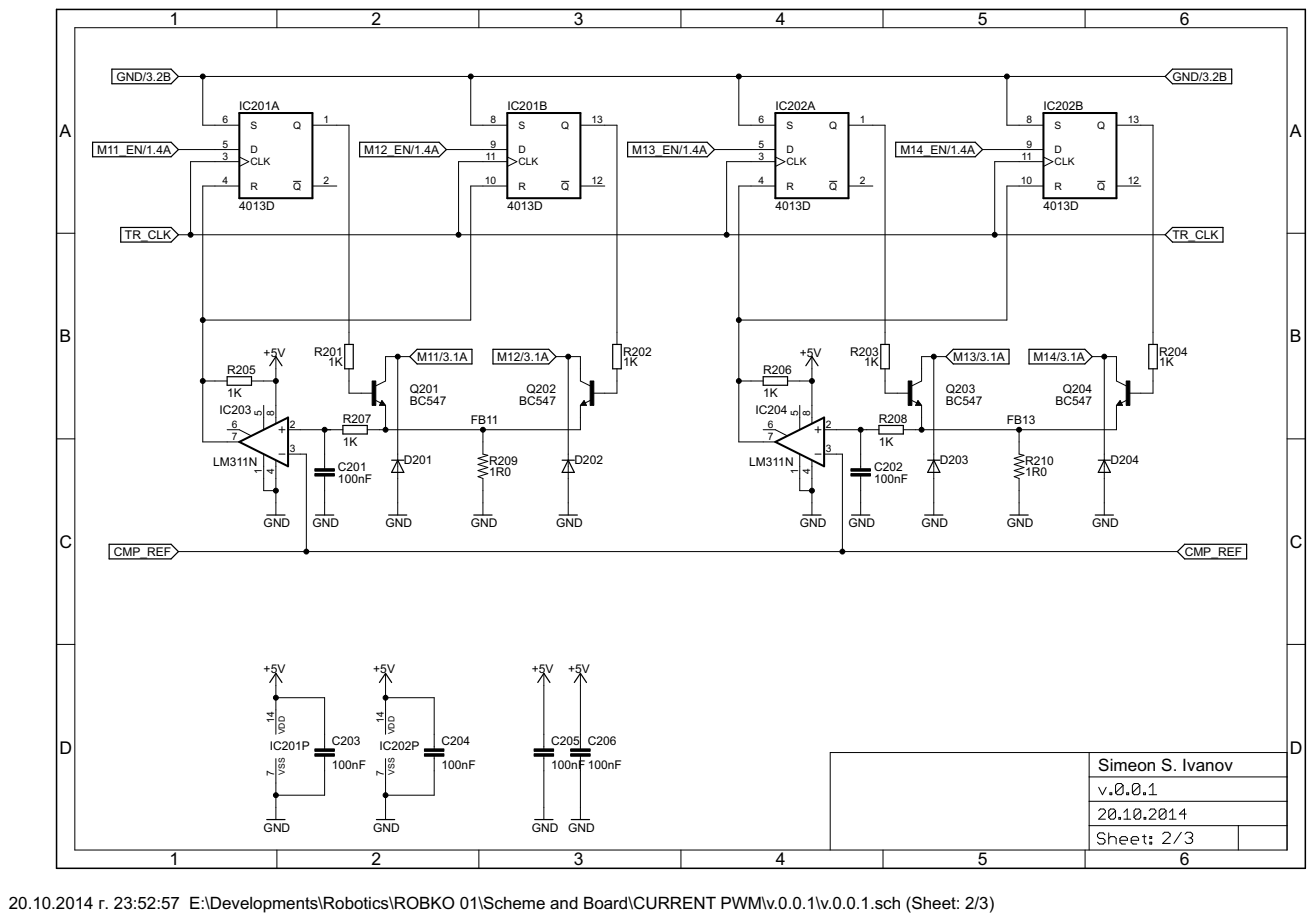
[picture p46: page 2]

20.10.2014 г. 23:52:57 E:\Developments\Robotics\ROBKO 01\Scheme and Board\CURRENT PWM\v.0.0.1\v.0.0.1.sch (Sheet: 2/3)

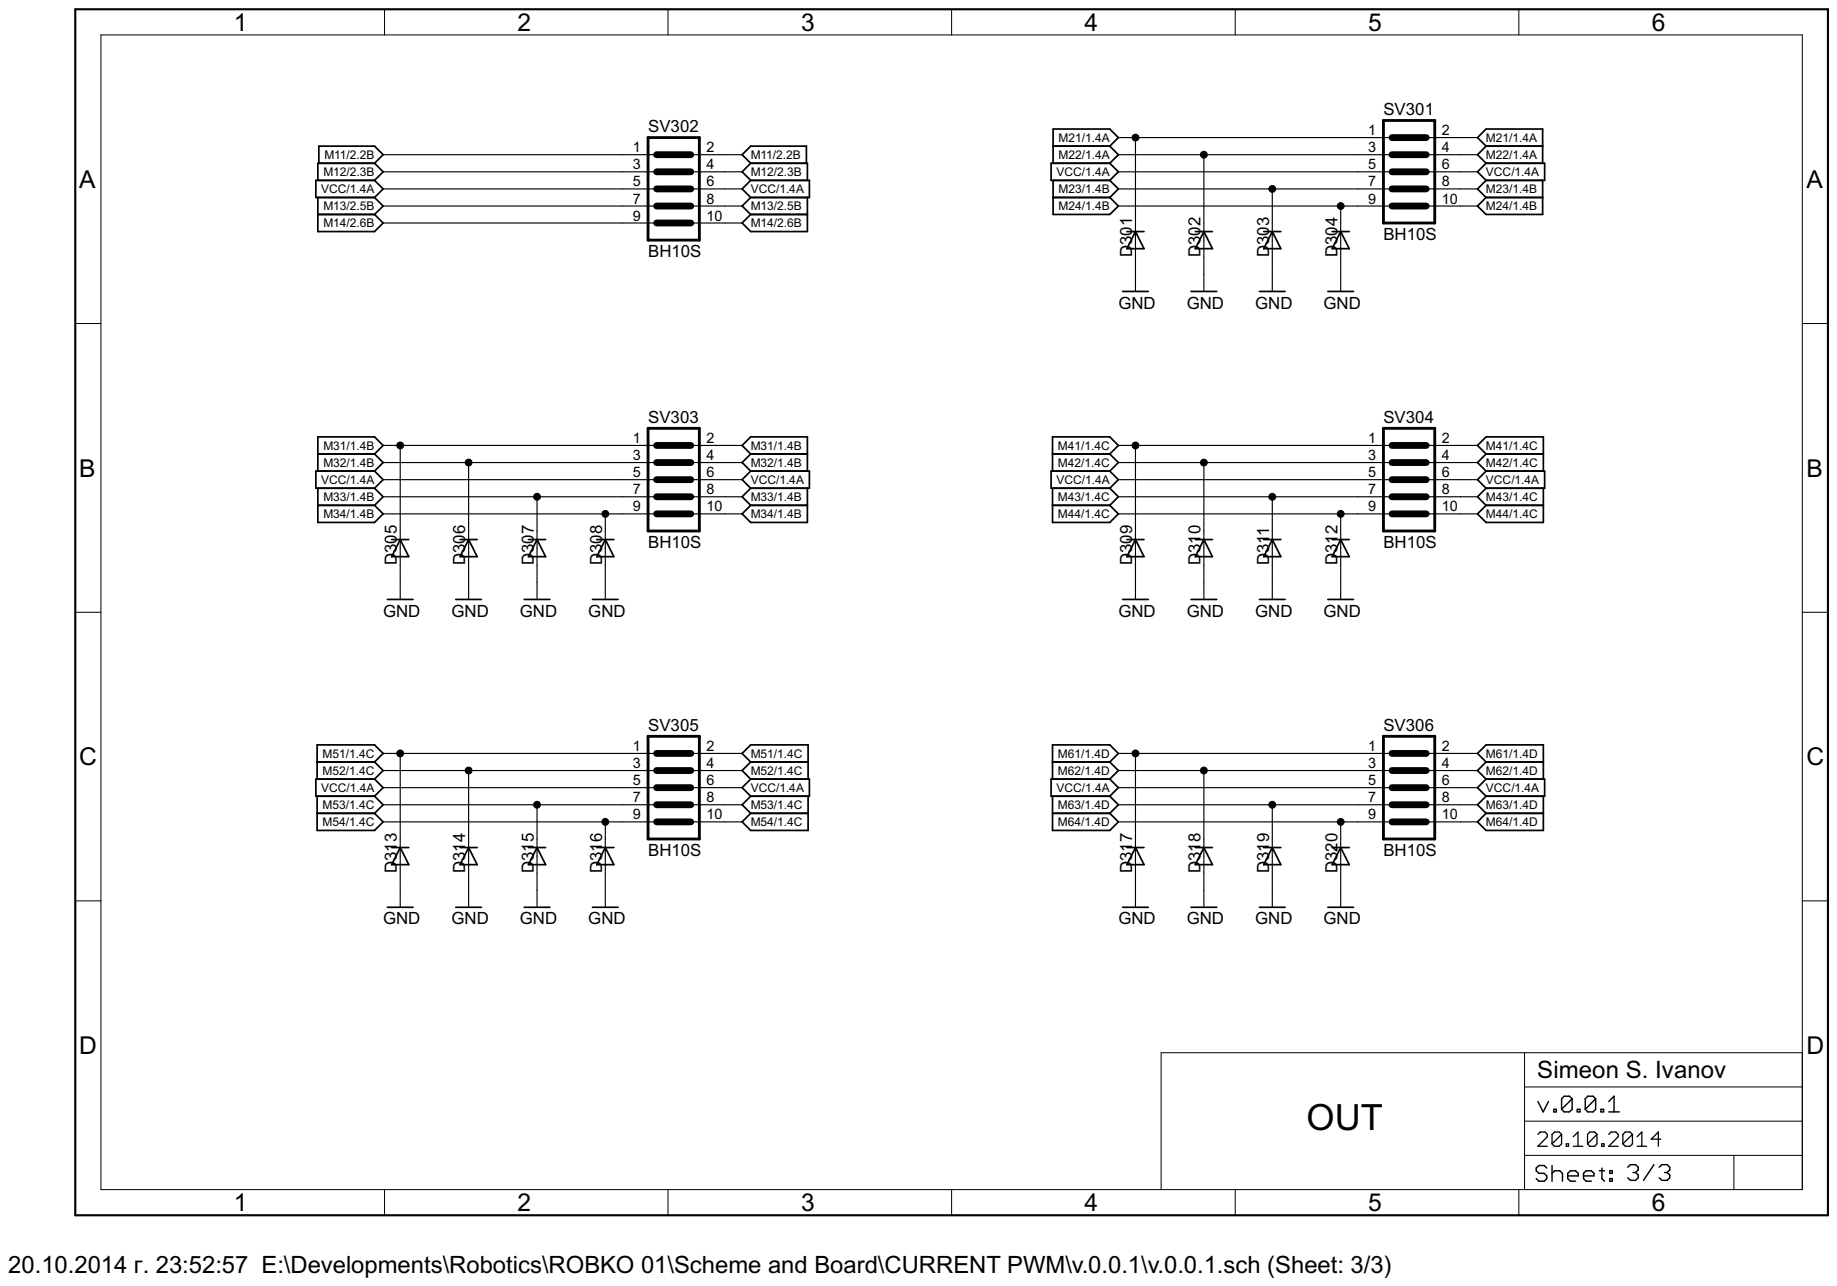
[picture p47: page 3]

20.10.2014 г. 23:52:57 E:\Developments\Robotics\ROBKO 01\Scheme and Board\CURRENT PWM\v.0.0.1\v.0.0.1.sch (Sheet: 3/3)
