SimeonSimeonovIvanov/ROBKO-01/Scheme and Board/CURRENT PWM/Copy of demo.pdf

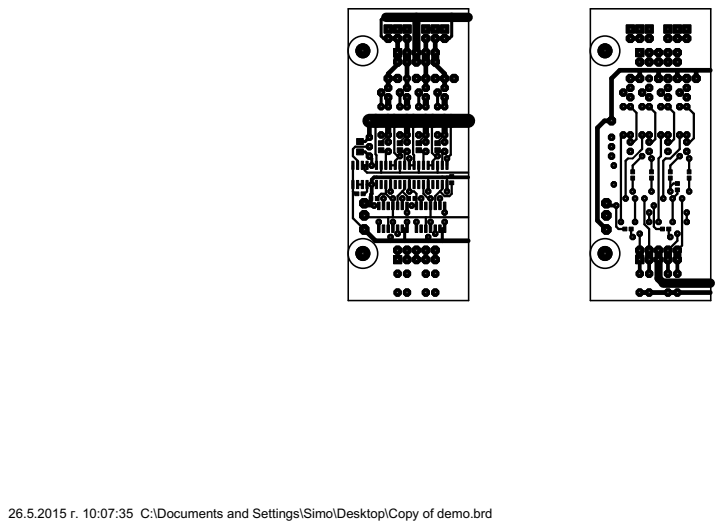
[picture p48: page 1]

26.5.2015 г. 10:07:35 C:\Documents and Settings\Simo\Desktop\Copy of demo.brd
