SimeonSimeonovIvanov/ROBKO-01/Scheme and Board/v.0.0.0/v.0.0.0 (Component - Bottom Side - Mirror).pdf

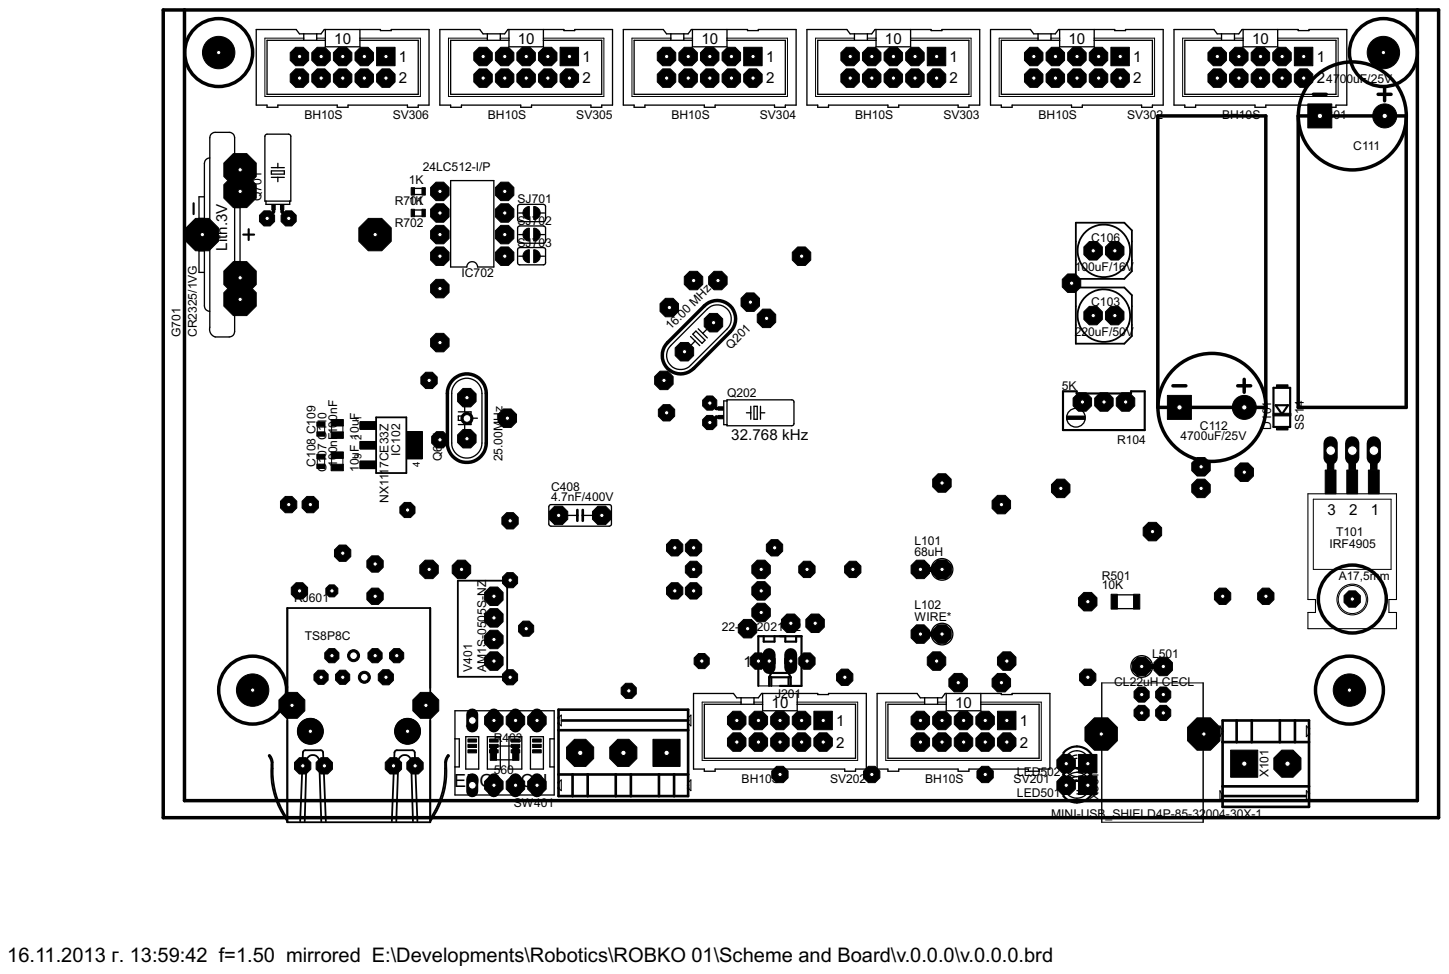
[picture p49: page 1]

16.11.2013 г. 13:59:42 f=1.50 mirrored E:\Developments\Robotics\ROBKO 01\Scheme and Board\v.0.0.0\v.0.0.0.brd
