SimeonSimeonovIvanov/ROBKO-01/Scheme and Board/v.0.0.0/v.0.0.0.pdf

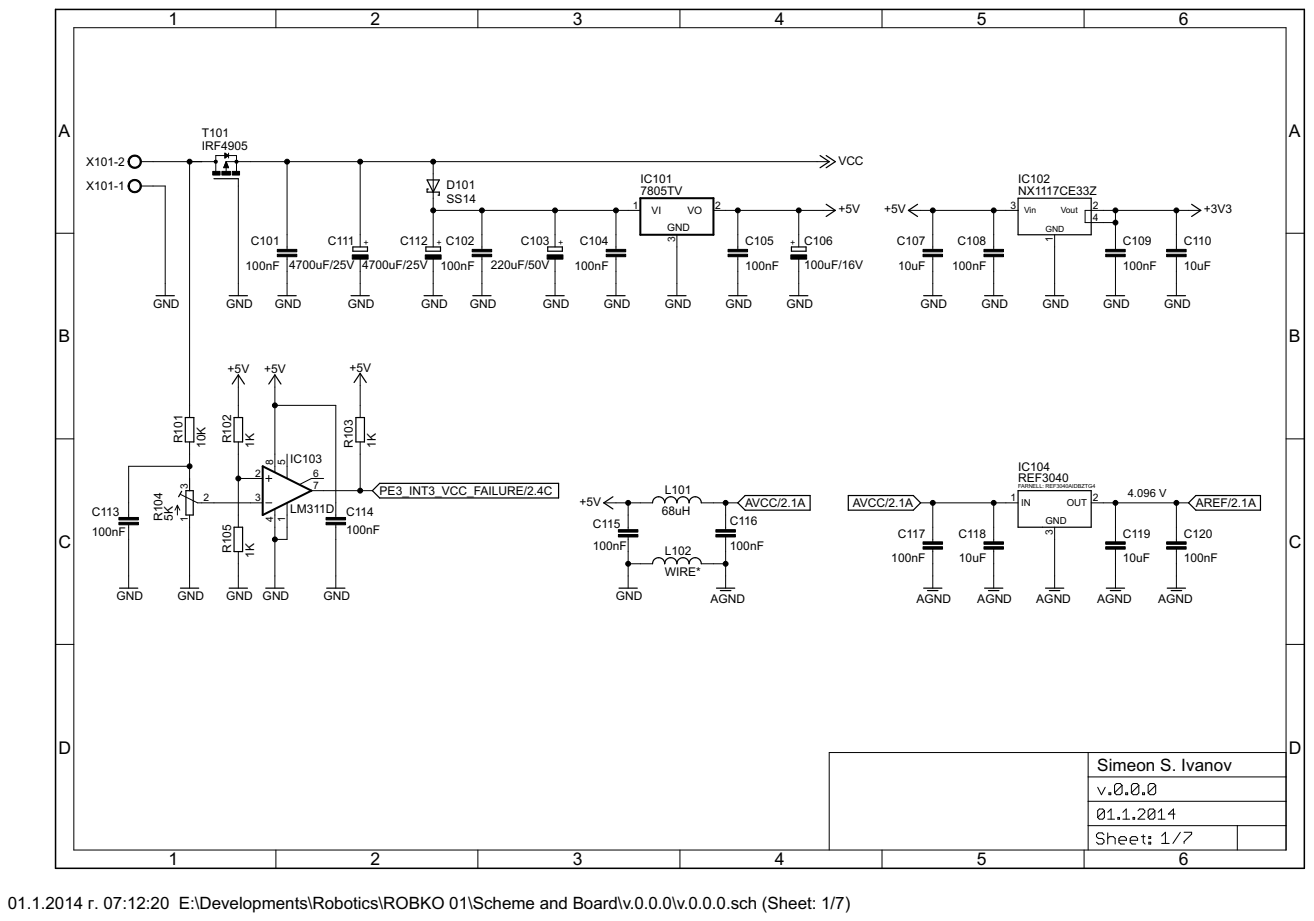
[picture p50: page 1]

01.1.2014 г. 07:12:20 E:\Developments\Robotics\ROBKO 01\Scheme and Board\v.0.0.0\v.0.0.0.sch (Sheet: 1/7)

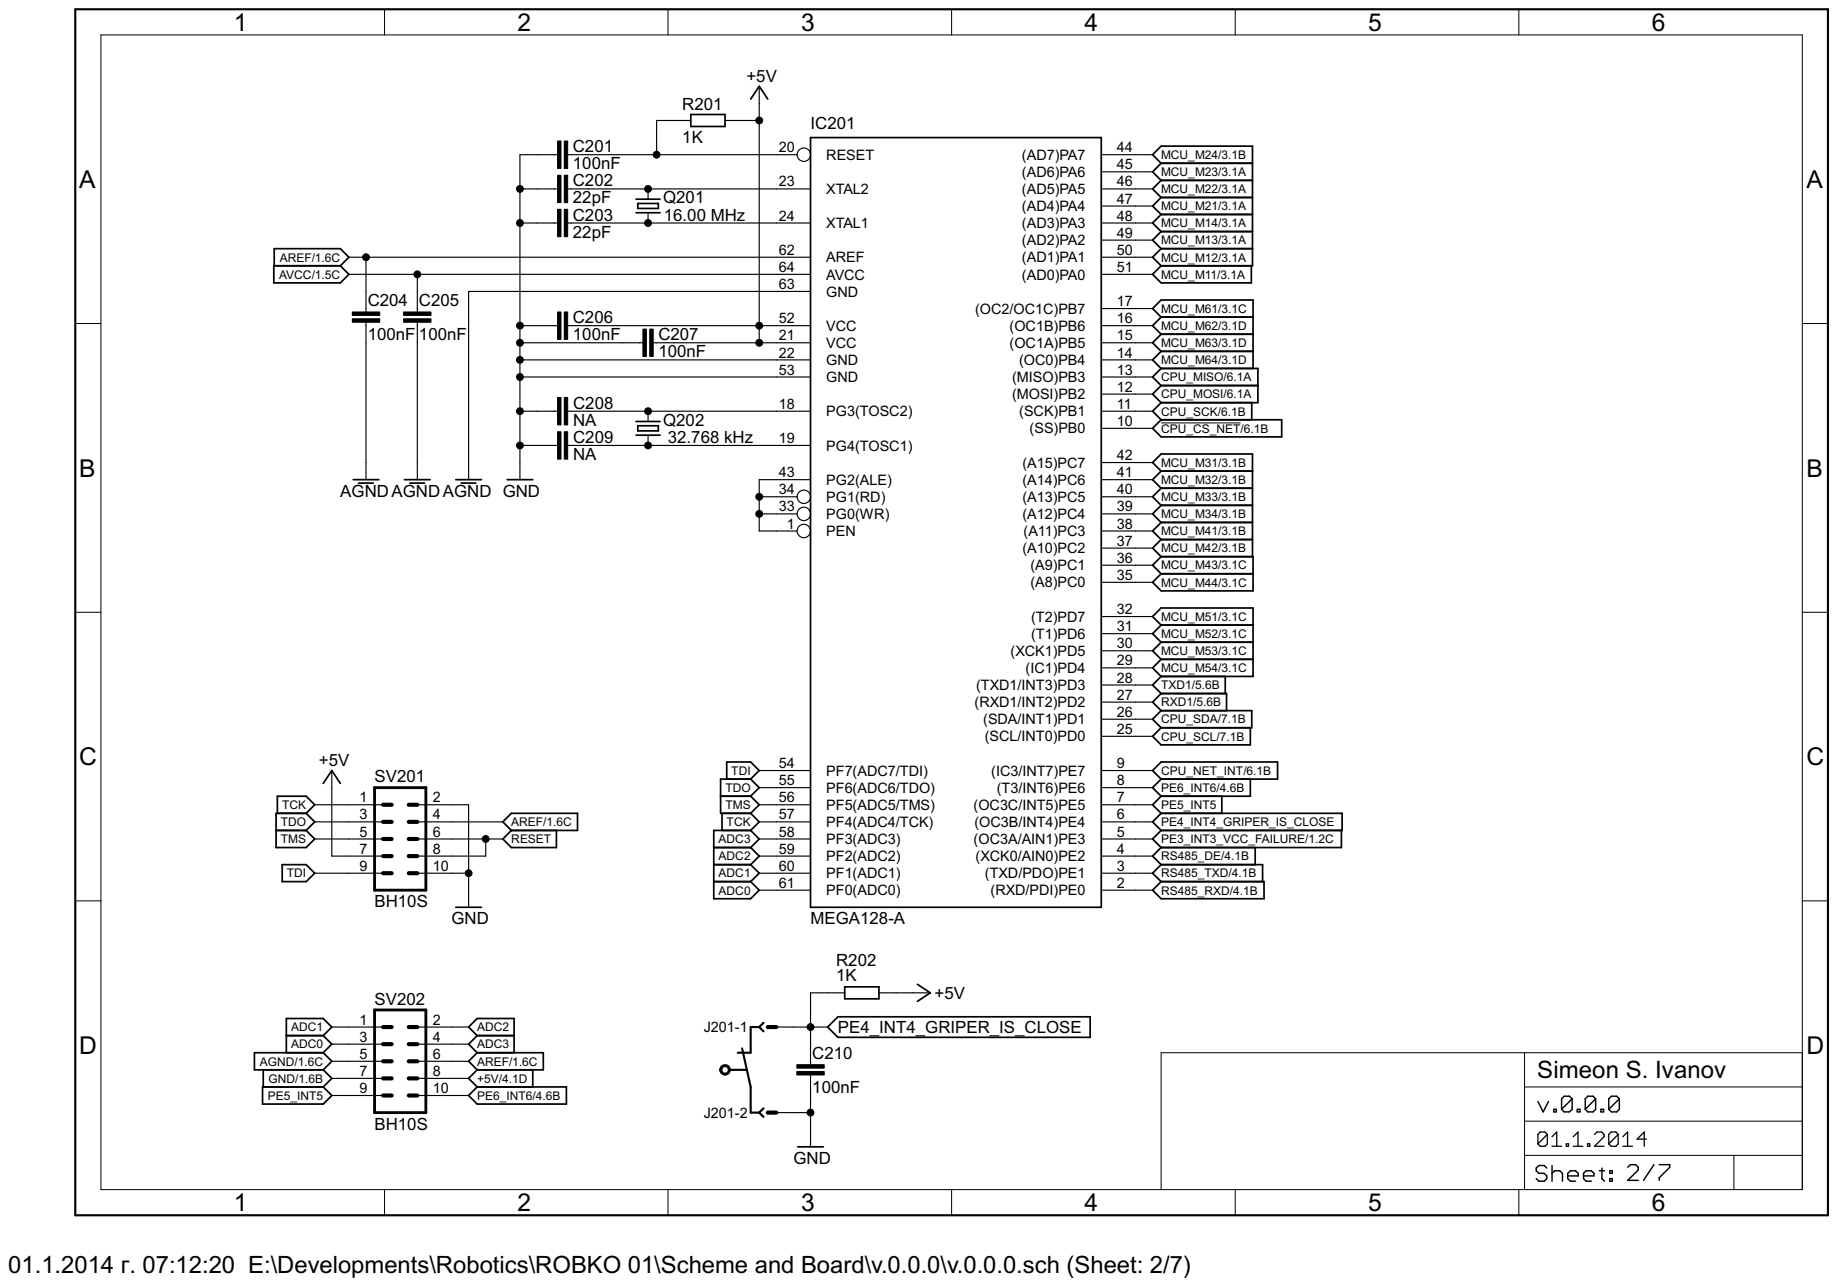
[picture p51: page 2]

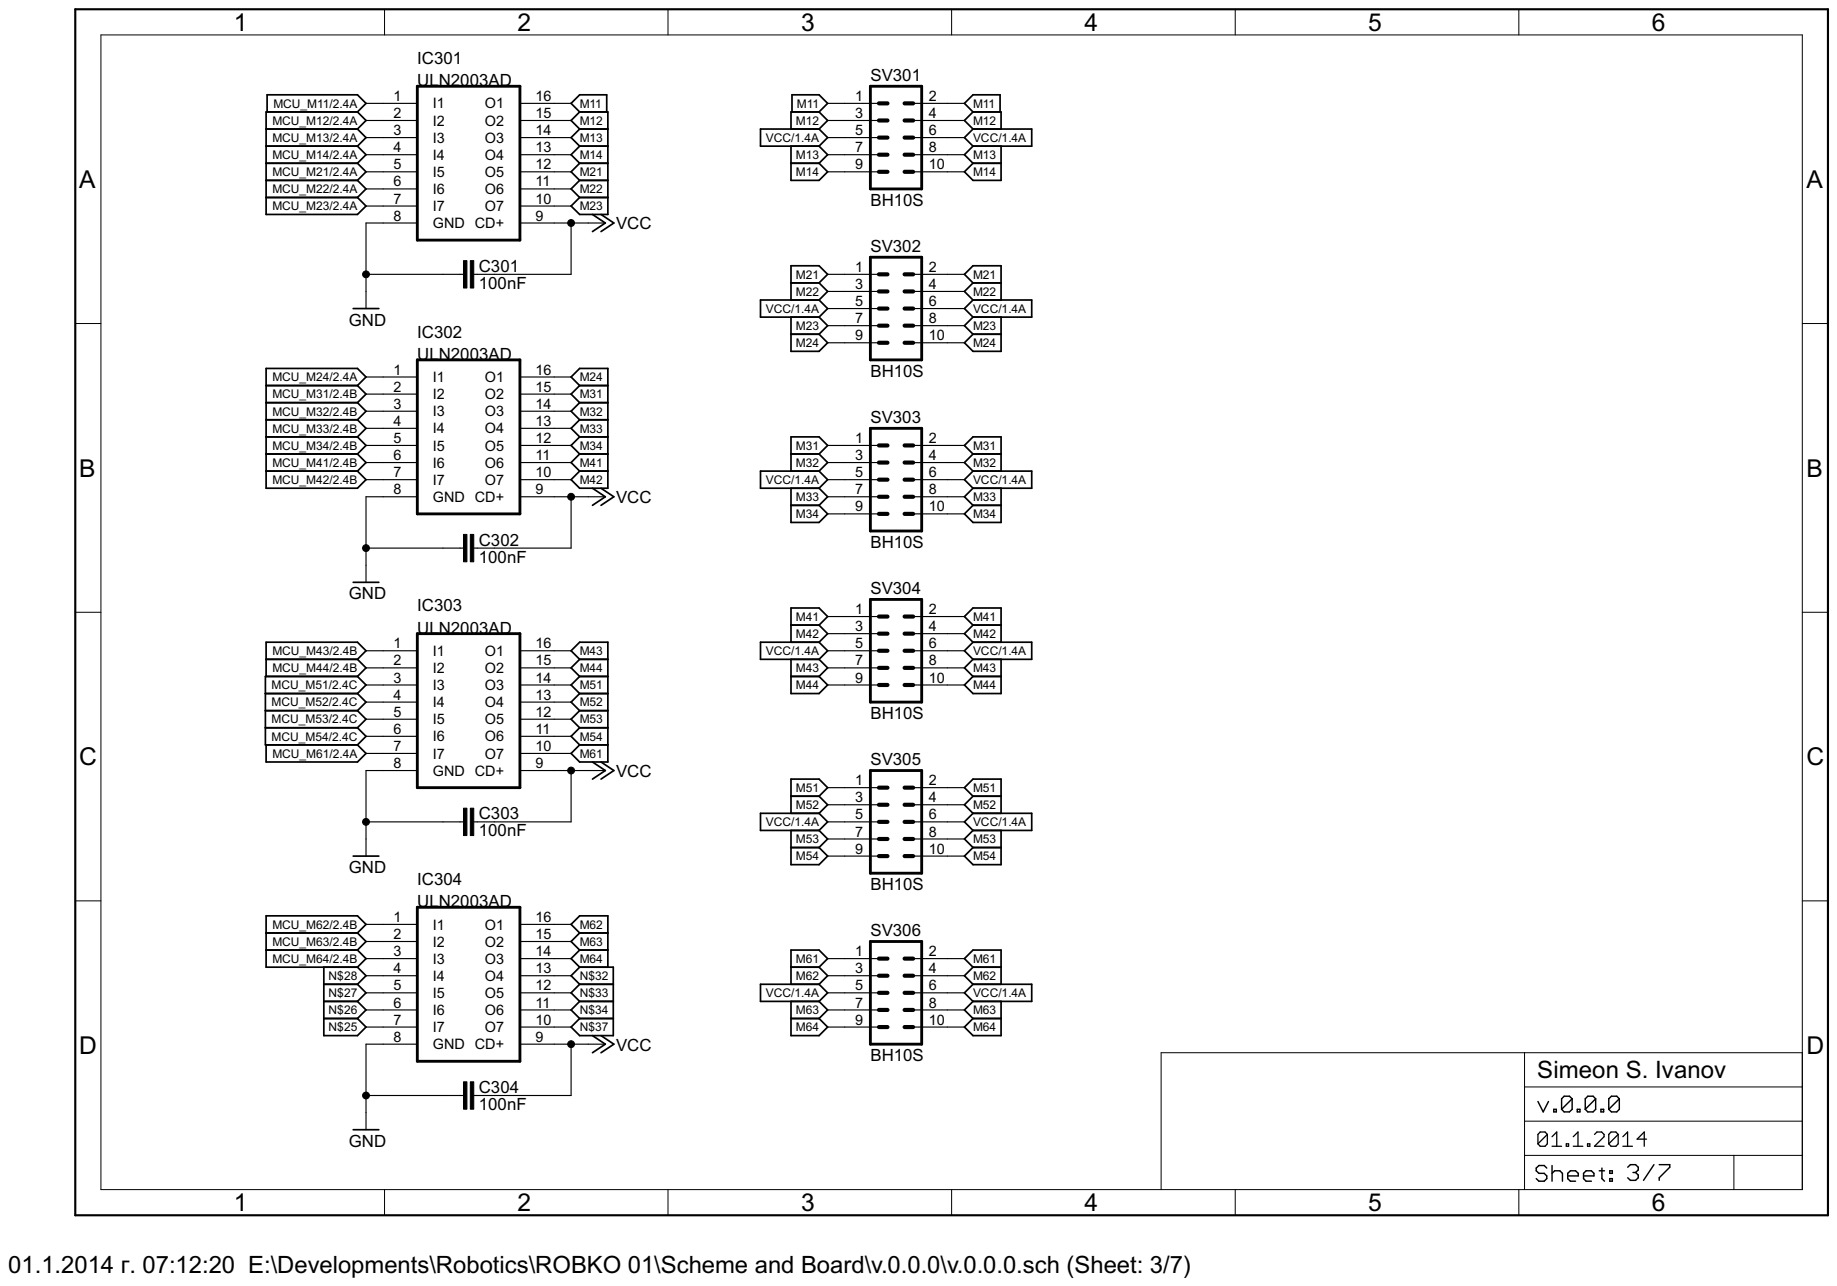
[picture p52: page 3]

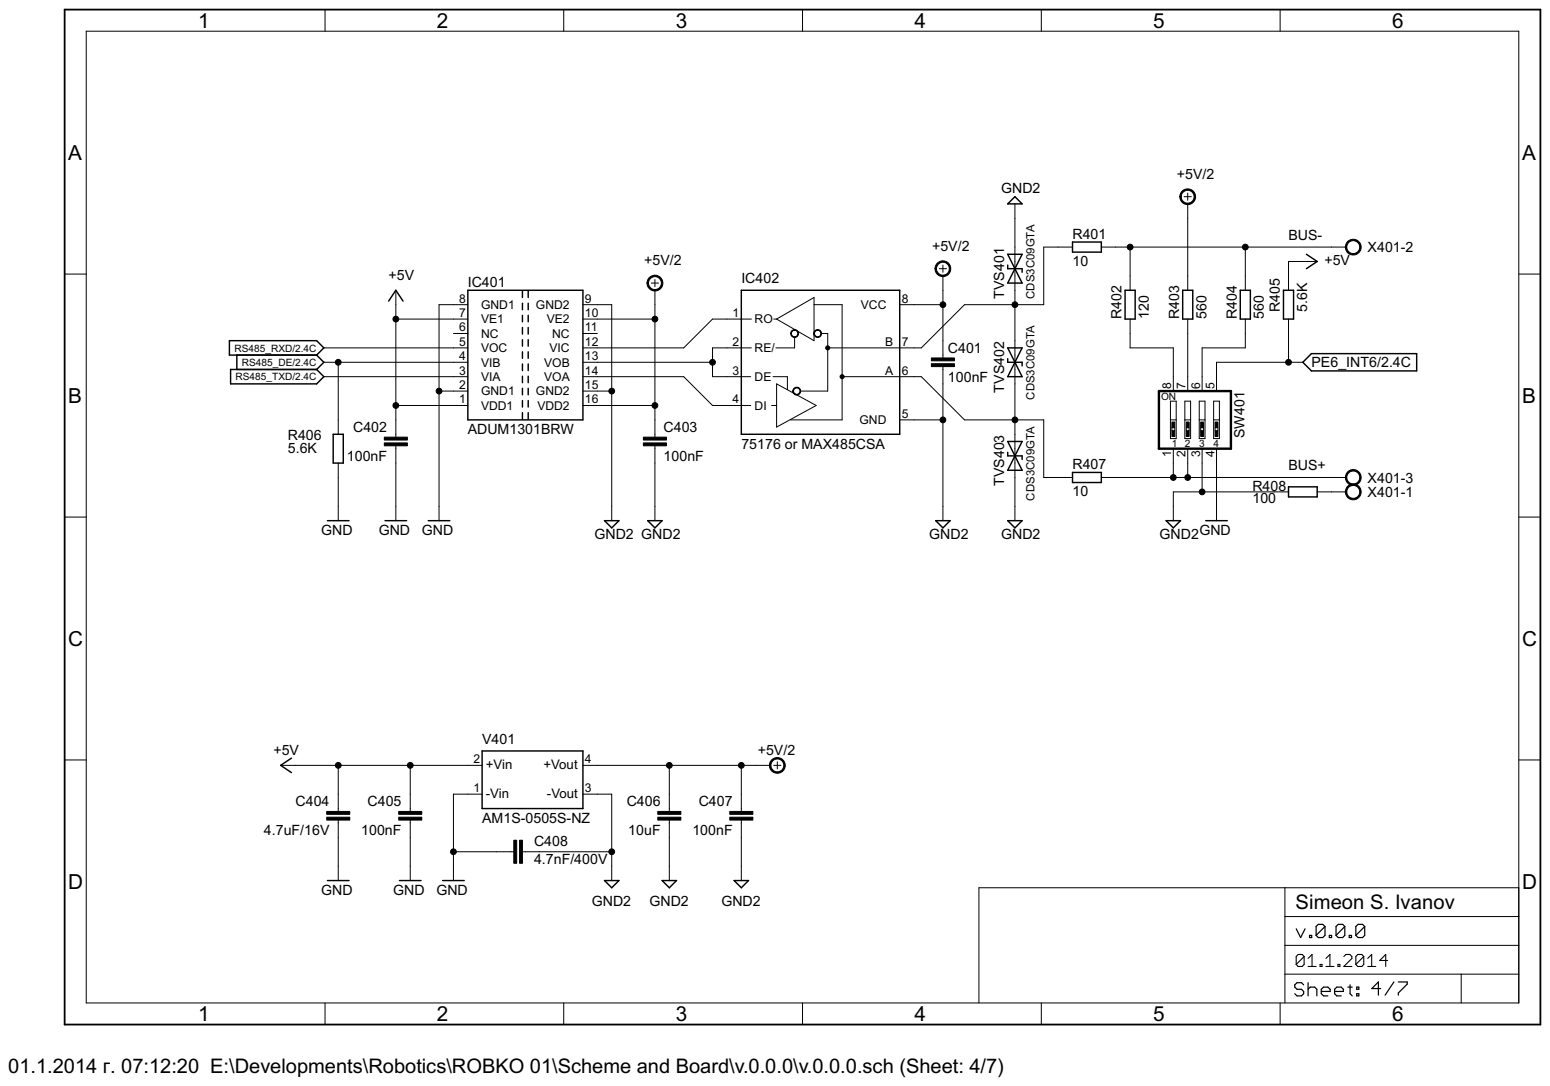
[picture p53: page 4]

01.1.2014 г. 07:12:20 E:\Developments\Robotics\ROBKO 01\Scheme and Board\v.0.0.0\v.0.0.0.sch (Sheet: 4/7)

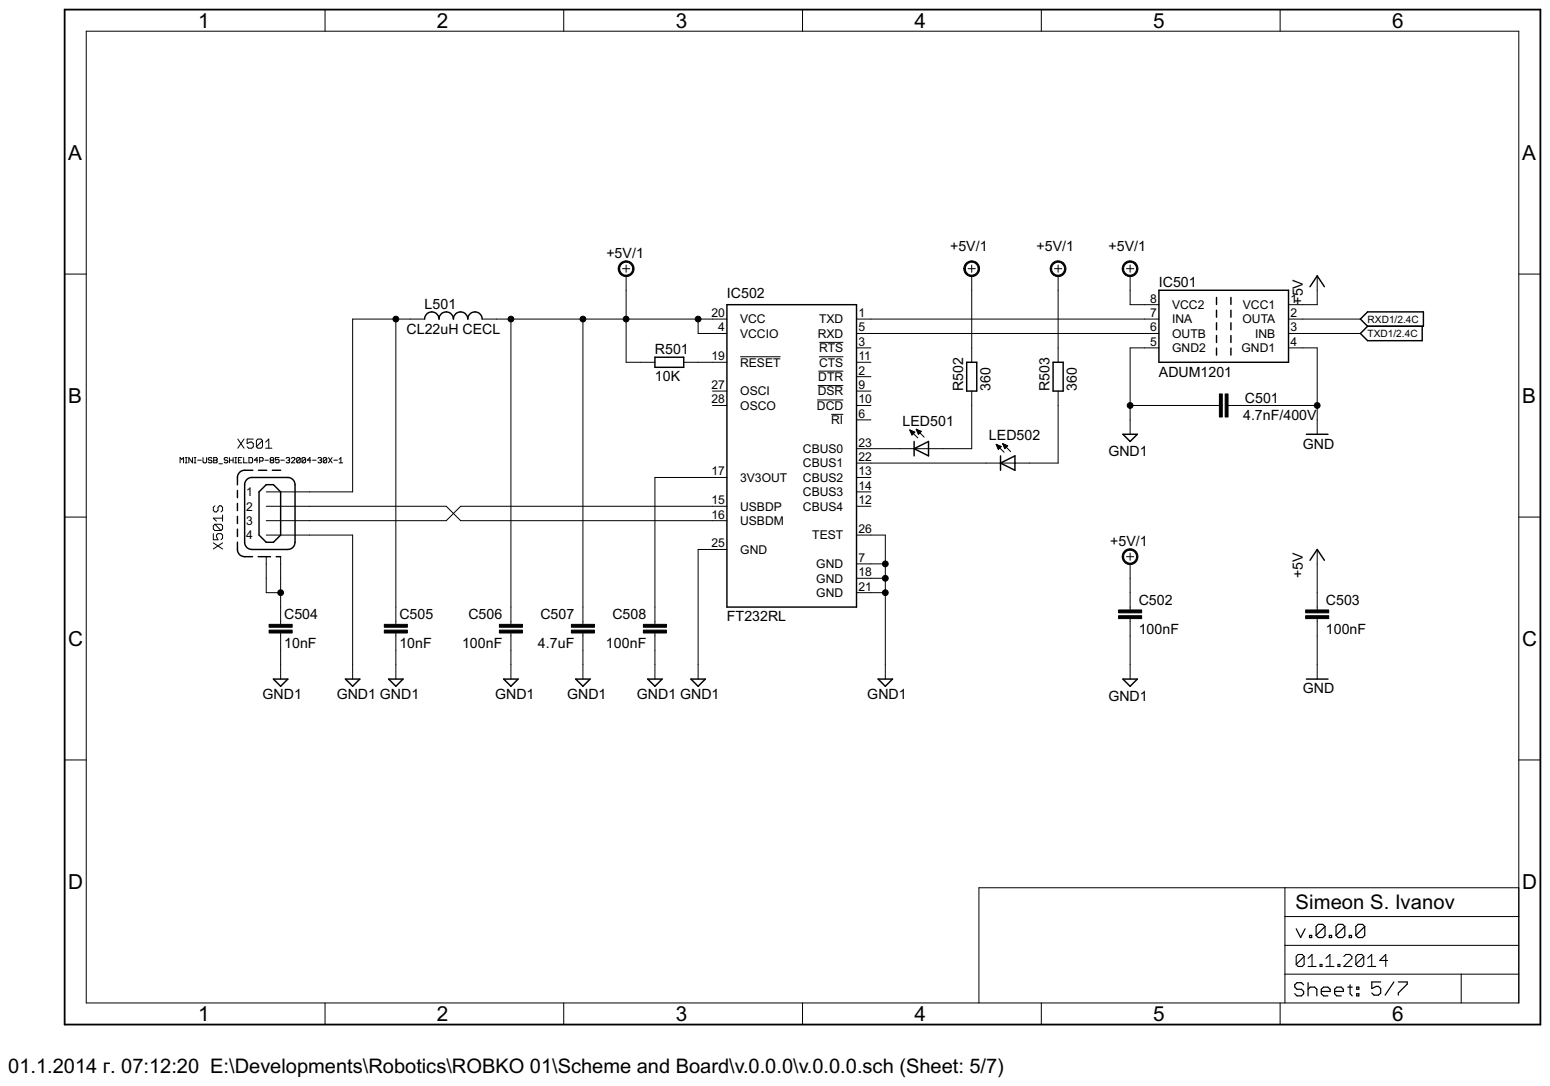
[picture p54: page 5]

01.1.2014 г. 07:12:20 E:\Developments\Robotics\ROBKO 01\Scheme and Board\v.0.0.0\v.0.0.0.sch (Sheet: 5/7)

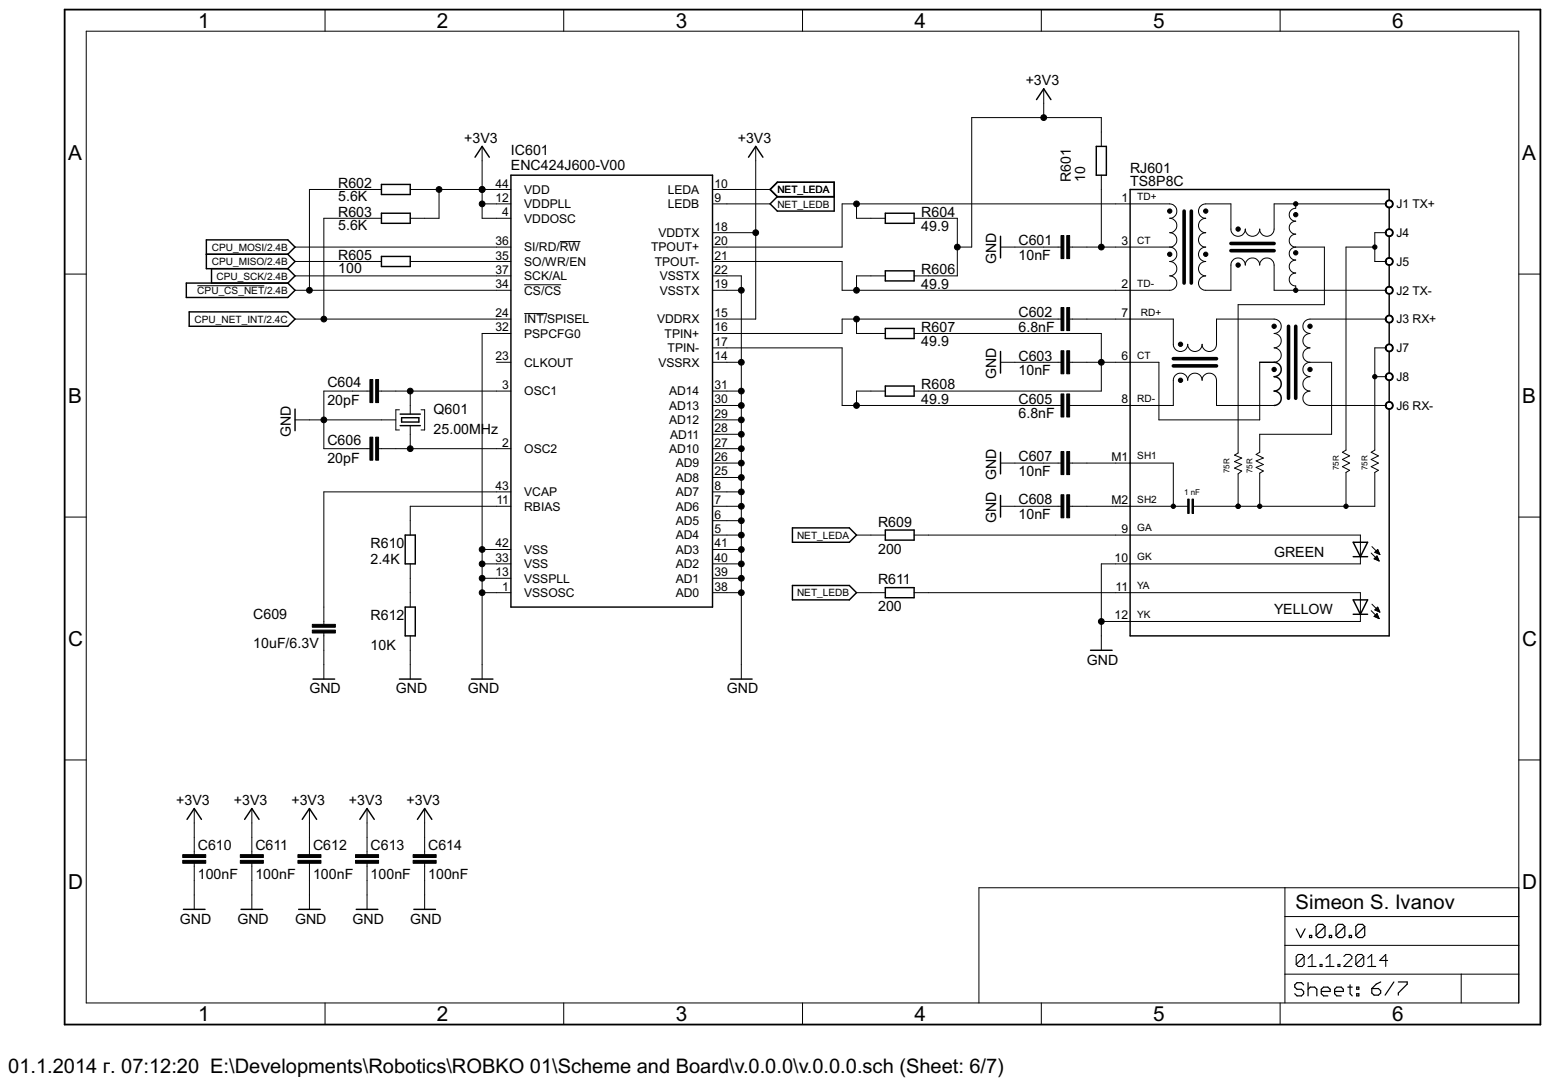
[picture p55: page 6]

01.1.2014 г. 07:12:20 E:\Developments\Robotics\ROBKO 01\Scheme and Board\v.0.0.0\v.0.0.0.sch (Sheet: 6/7)

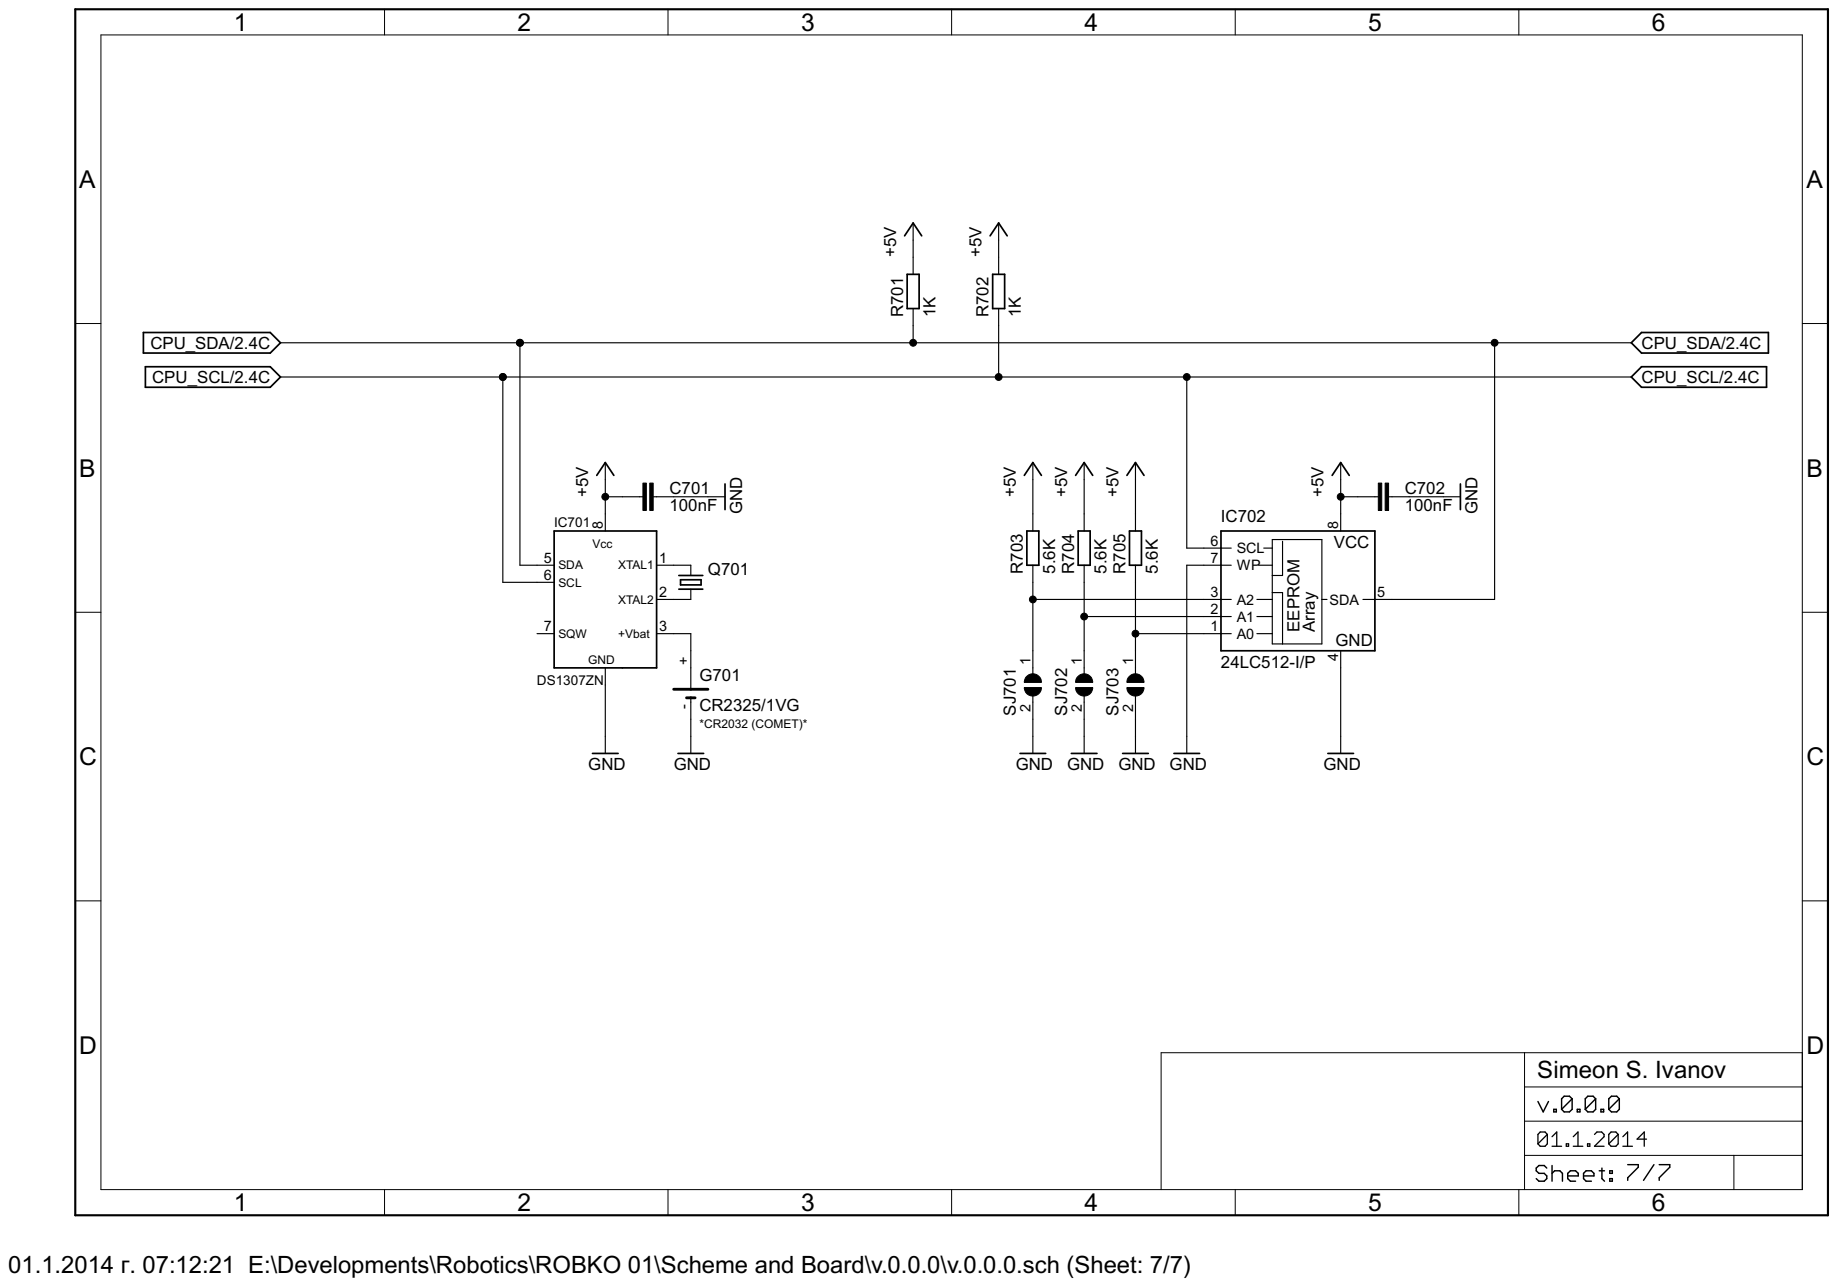
[picture p56: page 7]

01.1.2014 г. 07:12:21 E:\Developments\Robotics\ROBKO 01\Scheme and Board\v.0.0.0\v.0.0.0.sch (Sheet: 7/7)
