SimeonSimeonovIvanov/ROBKO-01/Scheme and Board/CURRENT PWM/v.0.0.0/demo (Bottom Side).pdf

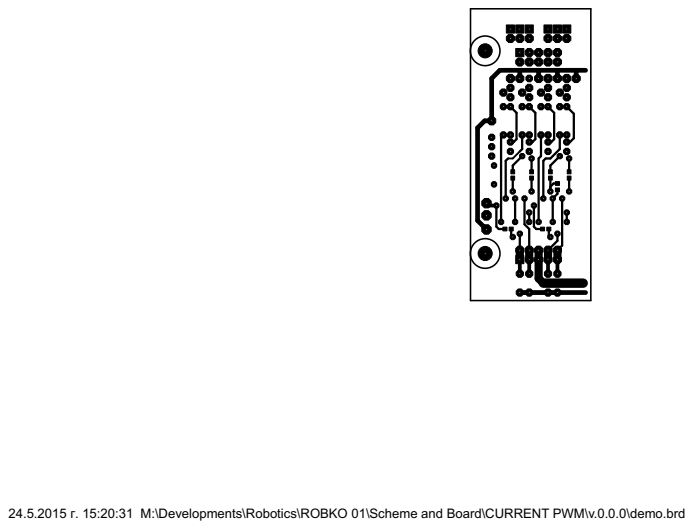
[picture p57: page 1]

24.5.2015 г. 15:20:31 M:\Developments\Robotics\ROBKO 01\Scheme and Board\CURRENT PWM\v.0.0.0\demo.brd
