SimeonSimeonovIvanov/ROBKO-01/Scheme and Board/CURRENT PWM/v.0.0.0/v.0.0.0.pdf

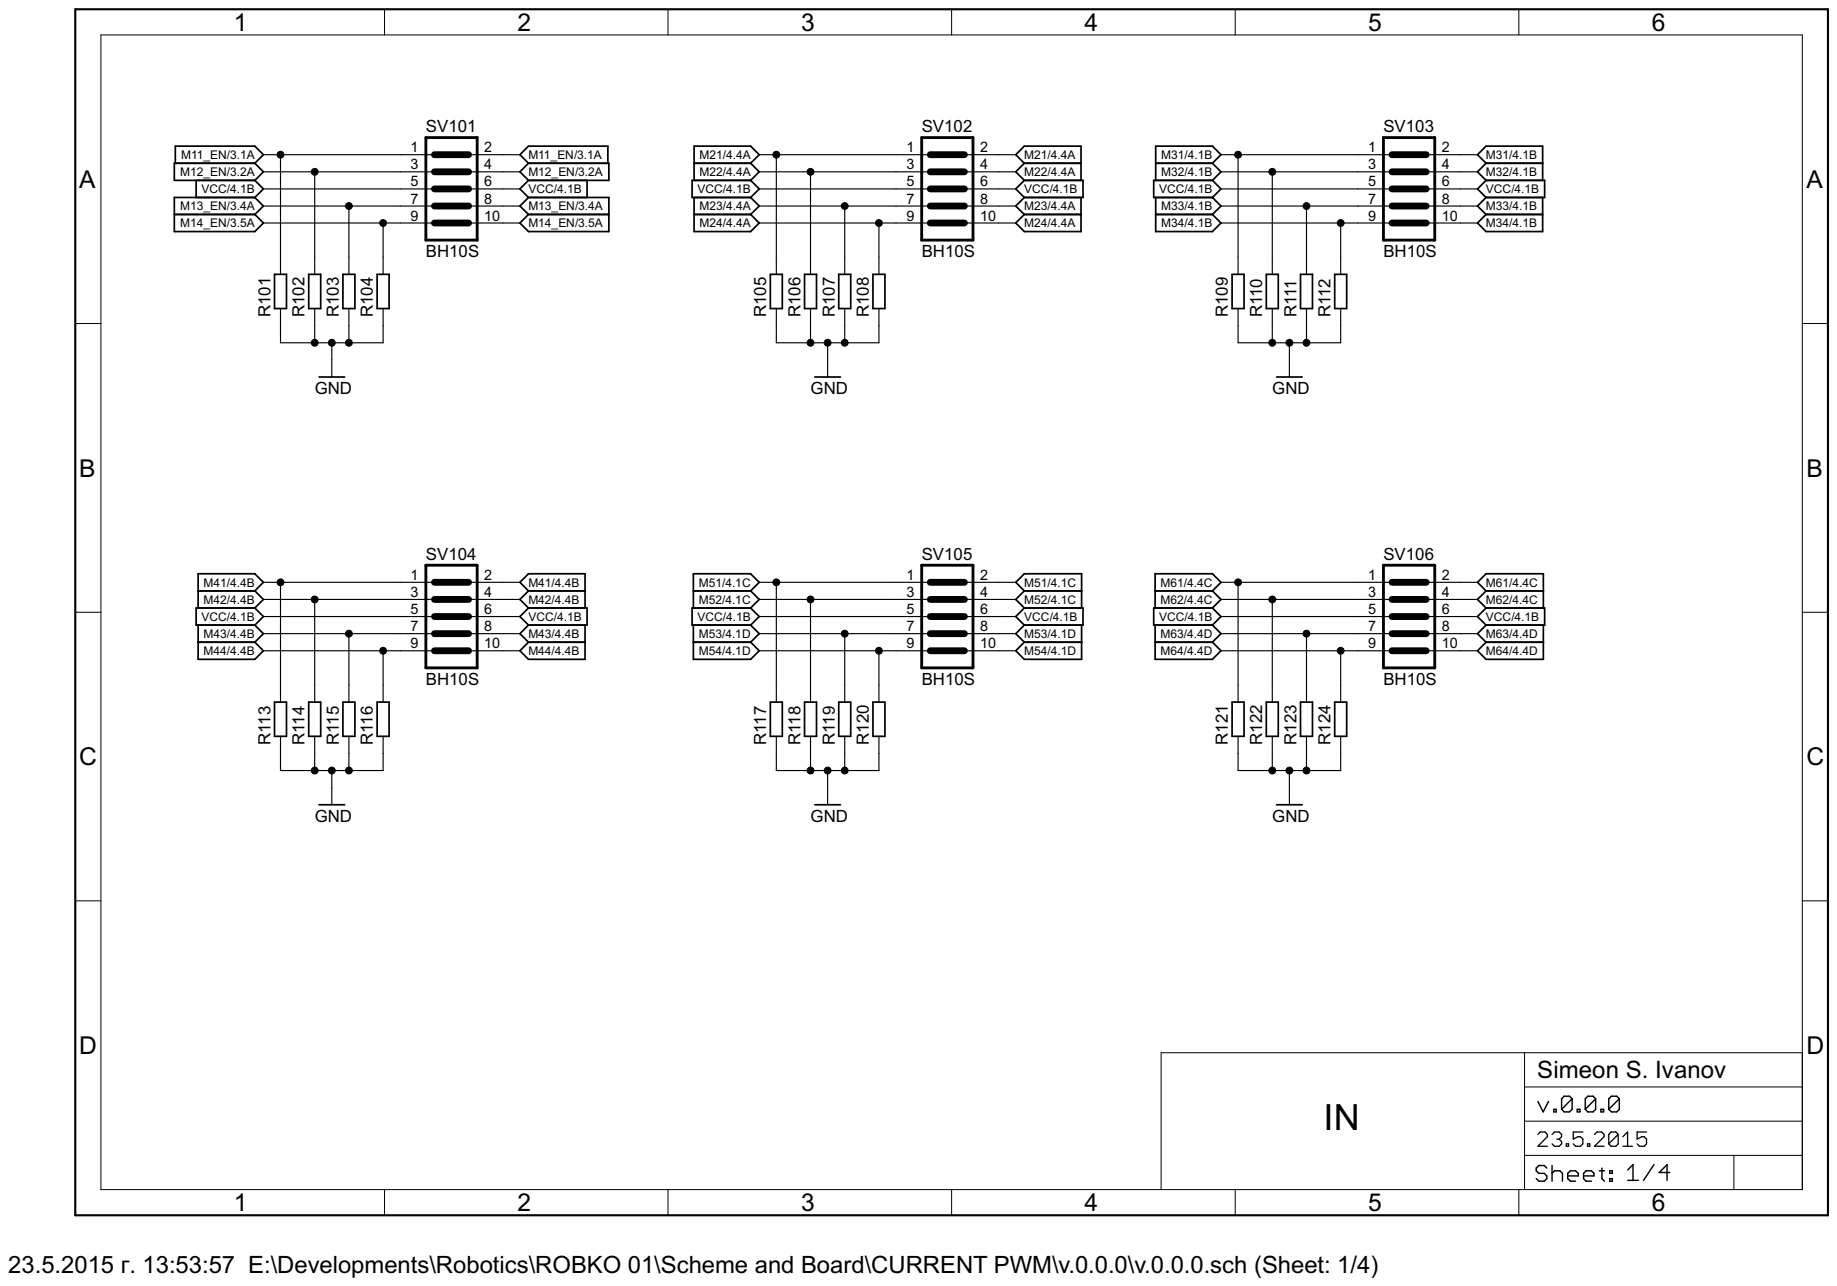
[picture p58: page 1]

23.5.2015 г. 13:53:57 E:\Developments\Robotics\ROBKO 01\Scheme and Board\CURRENT PWM\v.0.0.0\v.0.0.0.sch (Sheet: 1/4)

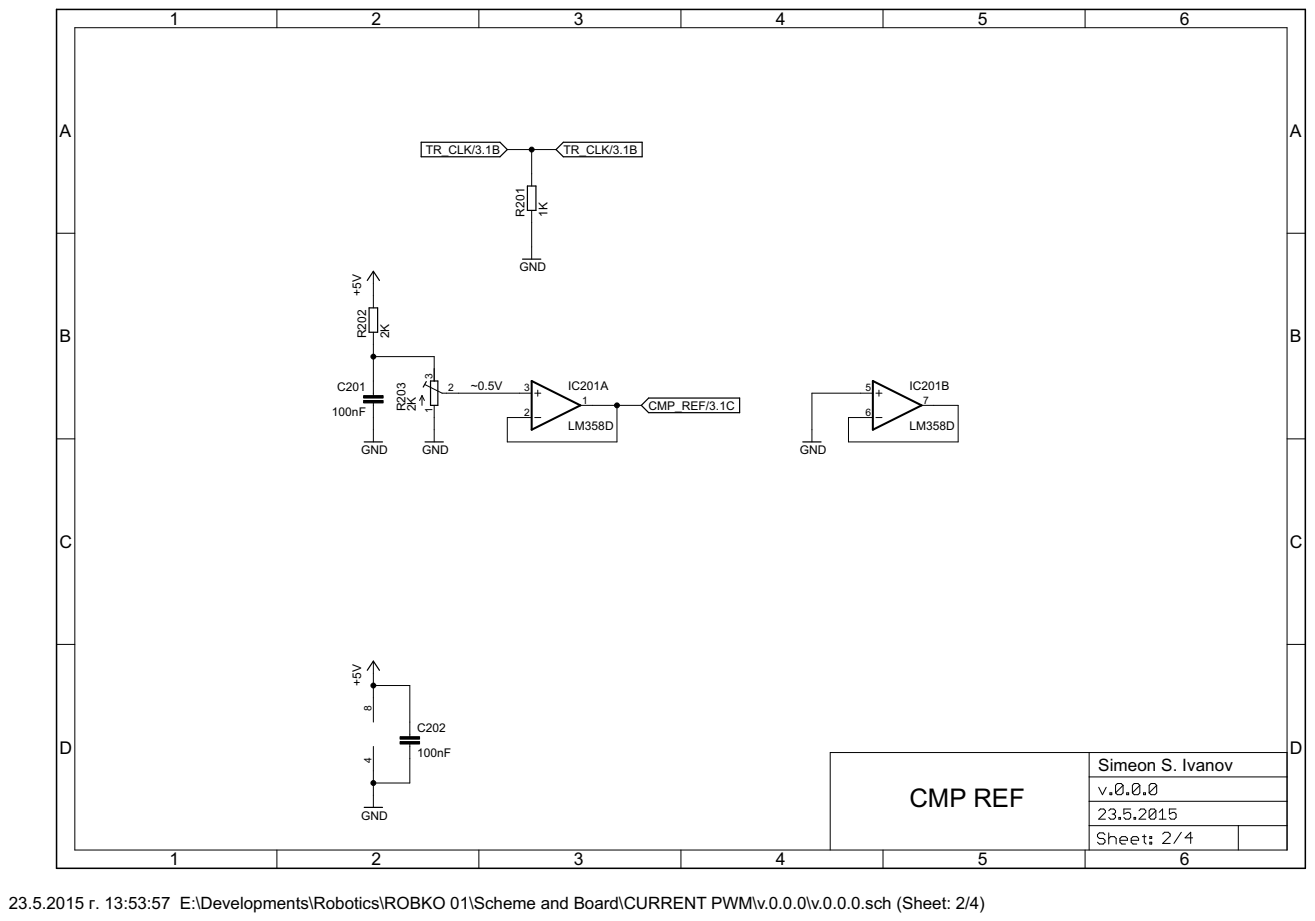
[picture p59: page 2]

23.5.2015 г. 13:53:57 E:\Developments\Robotics\ROBKO 01\Scheme and Board\CURRENT PWM\v.0.0.0\v.0.0.0.sch (Sheet: 2/4)

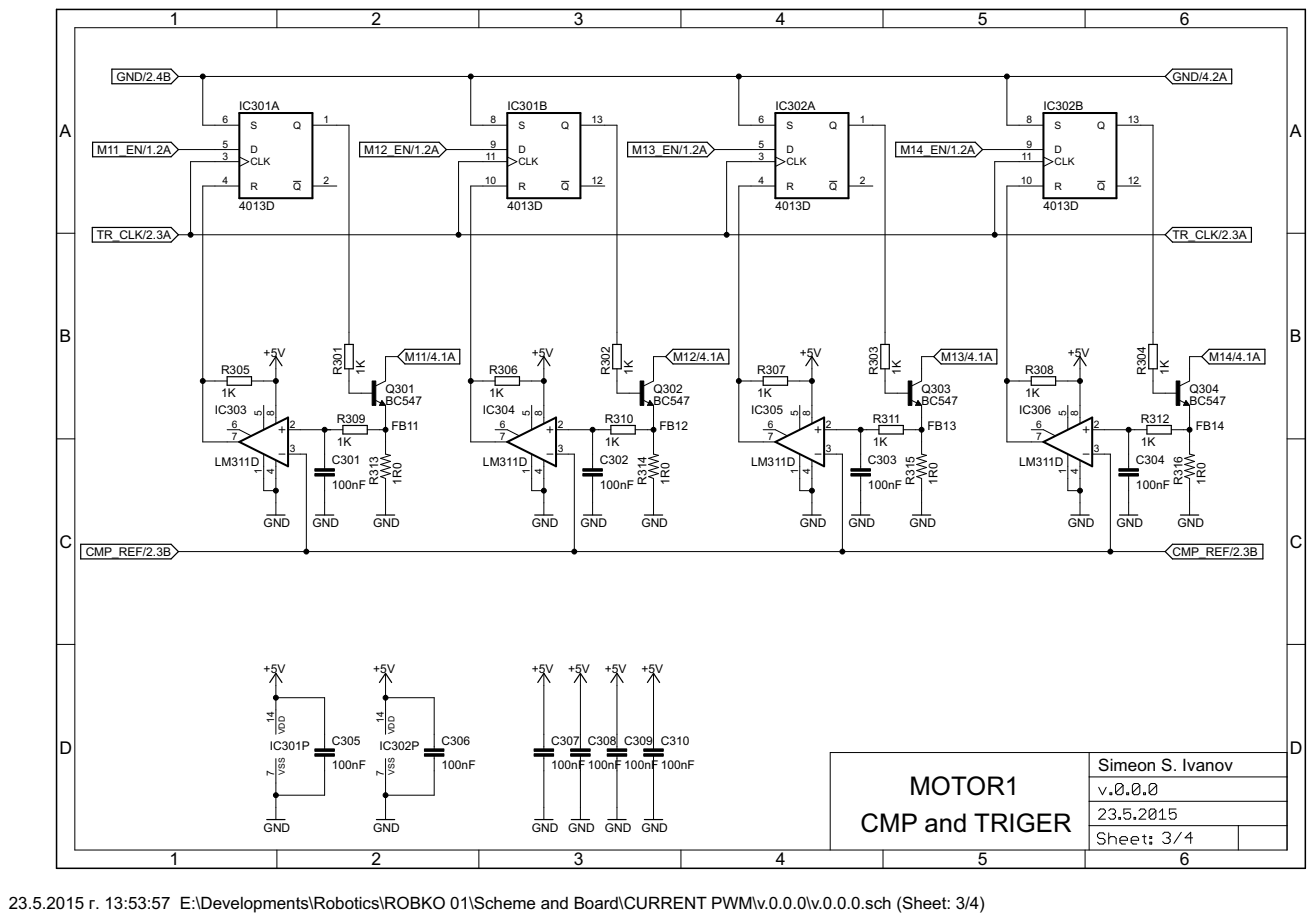
[picture p60: page 3]

GND GND

23.5.2015 г. 13:53:57 E:\Developments\Robotics\ROBKO 01\Scheme and Board\CURRENT PWM\v.0.0.0\v.0.0.0.sch (Sheet: 3/4)

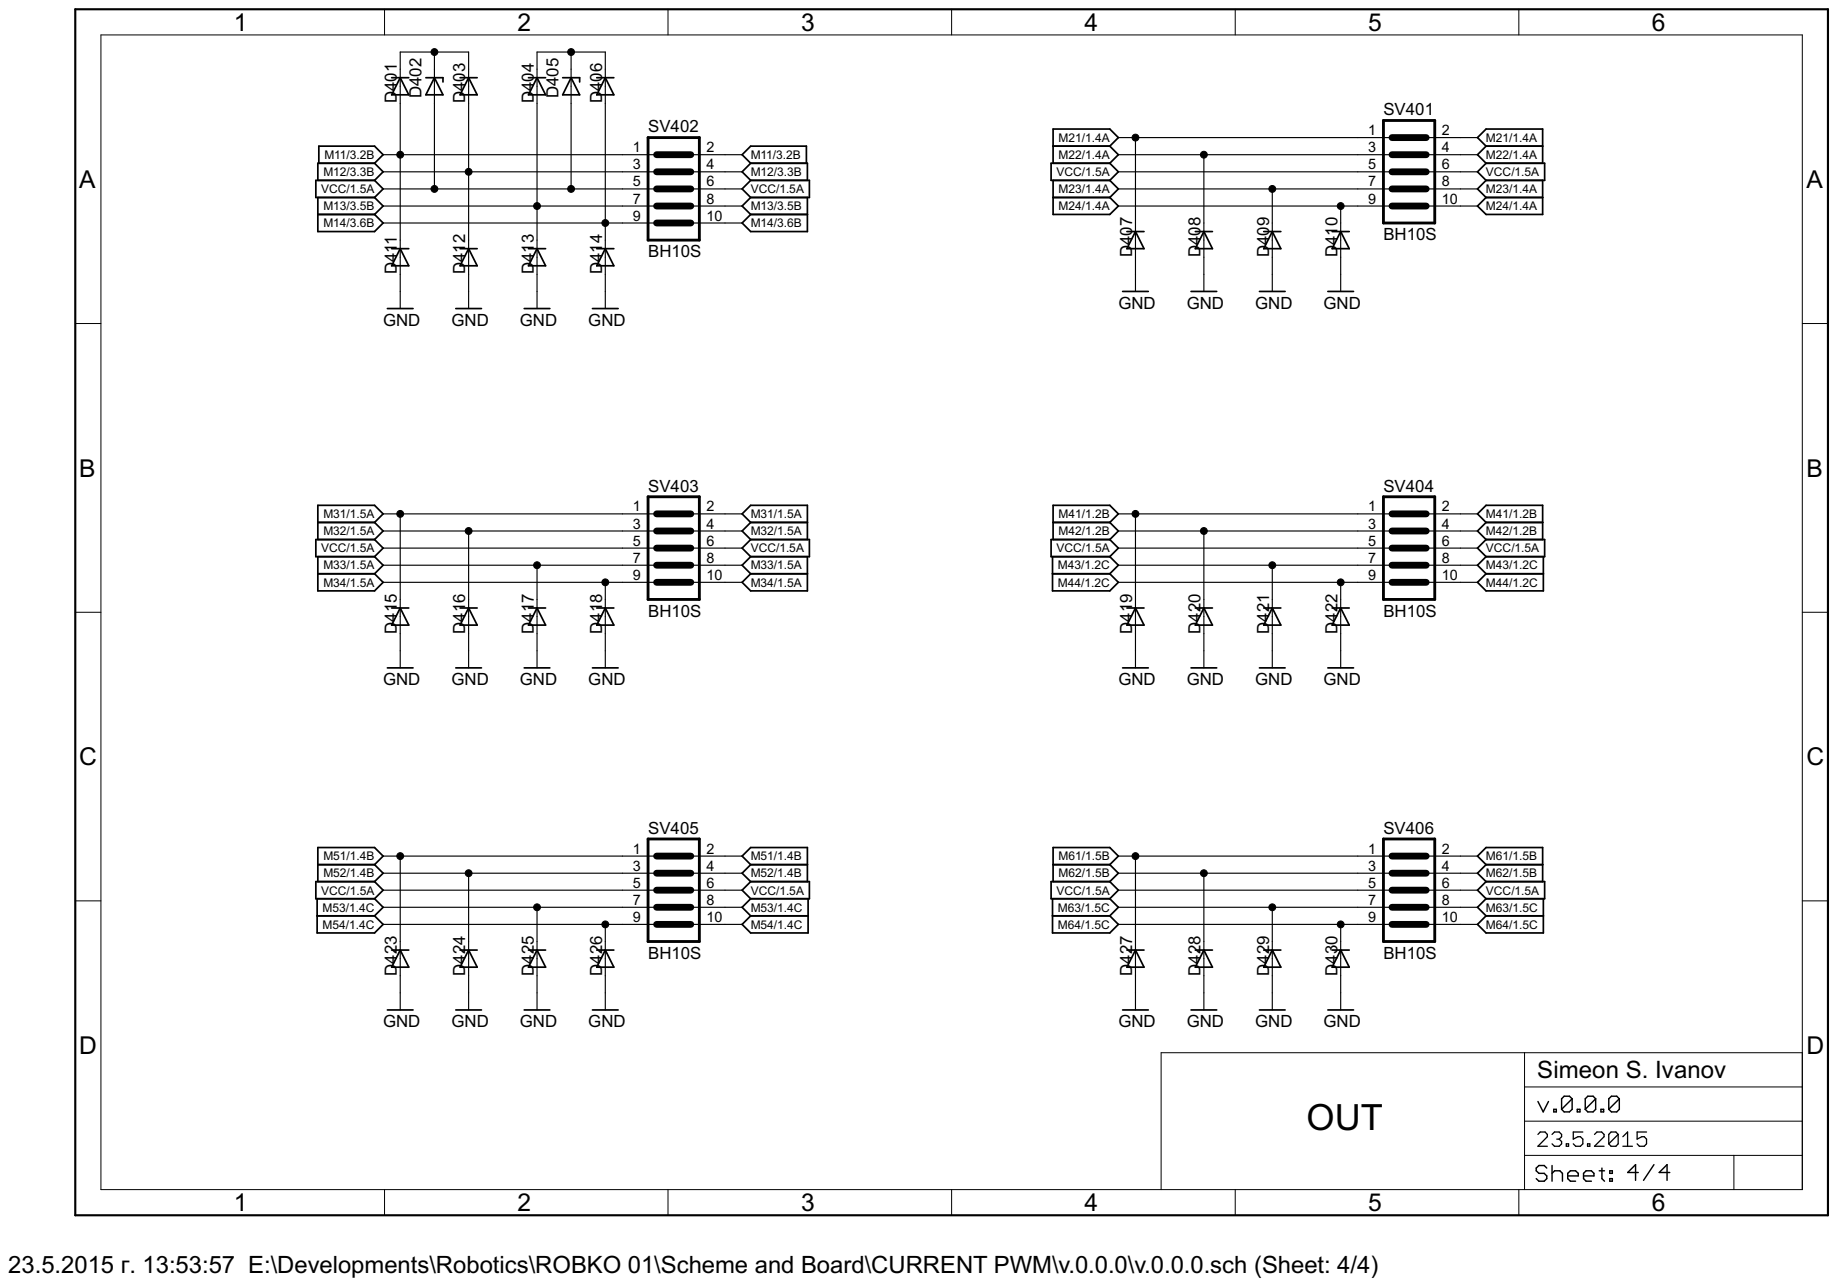
[picture p61: page 4]

23.5.2015 г. 13:53:57 E:\Developments\Robotics\ROBKO 01\Scheme and Board\CURRENT PWM\v.0.0.0\v.0.0.0.sch (Sheet: 4/4)
