SimeonSimeonovIvanov/ROBKO-01/src/v.0.0.0/FreeMODBUS/Master/Control Center/resource.h

//{{NO_DEPENDENCIES}}
// Microsoft Developer Studio generated include file.
// Used by com.rc
//
#define ID_HELP_ABOUT                   0
#define IDD_ABOUTBOX                    1
#define IDI_IDE                         2
#define IDM_CONNECTION_COMSELECT_COM1   3
#define IDM_CONNECTION_COMSELECT_COM2   4
#define IDM_CONNECTION_COMSELECT_COM3   5
#define IDM_CONNECTION_COMSELECT_COM4   6
#define IDM_CONNECTION_COMSELECT_COM5   7
#define IDM_CONNECTION_COMSELECT_COM6   8
#define IDM_CONNECTION_COMSELECT_COM7   9
#define IDM_CONNECTION_COMSELECT_COM8   10
#define IDM_CONNECTION_TCP_IP           11
#define IDC_IPADDRESS                   12
#define IDC_EDIT_TCP_PORT               13
#define IDD_TCP_SETINGS                 14
#define IDM_DISCONNECT                  15
#define IDM_CONNECTION_DISCONNECT       15
#define IDC_EDIT_MOTOR1                 17
#define IDC_EDIT_MOTOR2                 18
#define IDC_EDIT_MOTOR3                 19
#define IDC_EDIT_MOTOR4                 20
#define IDC_EDIT_MOTOR5                 21
#define IDC_EDIT_MOTOR6                 22
#define ID_ROBKO01_SET_ZERO_POSITION    23
#define ID_ROBKO01_SAVE_POS_TO_EEPROM   24
#define IDC_SPIN1                       101
#define IDC_SPIN2                       102
#define IDC_SPIN3                       103
#define IDC_SPIN4                       104
#define IDC_SPIN5                       105
#define IDC_SPIN6                       106
#define IDC_BUTTON_RUN_MOTOR1           29
#define IDC_BUTTON_RUN_MOTOR2           30
#define IDC_BUTTON_RUN_MOTOR3           31
#define IDC_BUTTON_RUN_MOTOR4           32
#define IDC_BUTTON_RUN_MOTOR5           33
#define IDC_BUTTON_RUN_MOTOR6           34
#define IDC_BUTTON_MOTOR1_DIRECTION     35
#define IDC_BUTTON_MOTOR2_DIRECTION     36
#define IDC_BUTTON_MOTOR3_DIRECTION     37
#define IDC_BUTTON_MOTOR4_DIRECTION     38
#define IDC_BUTTON_MOTOR5_DIRECTION     39
#define IDC_BUTTON_MOTOR6_DIRECTION     40
#define IDC_BUTTON_RUN_ALL              41
#define IDM_CONNECTION_SETINGS          42
#define IDC_STATIC_POWER                43
#define IDM_CONNECTION_COMSELECT_TCP_IP 44
#define IDC_BUTTON_SET_FK_VALUE         45
#define IDC_BUTTON_SET_FK_SET           46
#define IDC_EDIT_X                      47
#define IDC_EDIT_Y                      48
#define IDC_EDIT_Z                      49
#define IDC_BUTTON_SET_FK_GET           50
#define IDC_EDIT_R_GRIPER               51
#define IDC_EDIT_P_GRIPER               52
#define IDC_EDIT_GRIPER                 53
#define IDC_STATIC_FK_X                 54
#define IDC_STATIC_FK_Y                 55
#define IDC_STATIC_FK_Z                 56
#define IDC_BUTTON_SET_IK_G01           57
#define IDC_STATIC_FK_P                 58
#define IDC_STATIC_FK_R                 59
#define IDC_STATIC_FK_G                 60
#define IDC_BUTTON_EMS                  61
#define IDC_BUTTON_SET_IK_G01_L         62
#define IDC_EDIT_G_CODE                 65
#define IDC_BUTTON_RUN_G_CODE           66
#define IDD_MAIN                        100
#define IDR_MENU_MAIN                   101
#define IDC_COMBO_PORT                  104
#define IDC_BUTTON_CONNECT              105
#define IDC_COMBO_SLAVE_ID              106

// Next default values for new objects
// 
#ifdef APSTUDIO_INVOKED
#ifndef APSTUDIO_READONLY_SYMBOLS
#define _APS_NEXT_RESOURCE_VALUE        8
#define _APS_NEXT_COMMAND_VALUE         25
#define _APS_NEXT_CONTROL_VALUE         67
#define _APS_NEXT_SYMED_VALUE           0
#endif
#endif
