SimeonSimeonovIvanov/ROBKO-01/src/OpenGL/OpenGL.h

#if !defined(AFX_OPENGL_H__055F35C3_DA94_4E73_A43B_53B95BC7F690__INCLUDED_)
#define AFX_OPENGL_H__055F35C3_DA94_4E73_A43B_53B95BC7F690__INCLUDED_

#if _MSC_VER > 1000
#pragma once
#endif // _MSC_VER > 1000

#include "resource.h"


#endif // !defined(AFX_OPENGL_H__055F35C3_DA94_4E73_A43B_53B95BC7F690__INCLUDED_)
