SimeonSimeonovIvanov/ROBKO-01/src/OpenGL/resource.h

//{{NO_DEPENDENCIES}}
// Microsoft Visual C++ generated include file.
// Used by OPENGL.RC
//
#define IDR_MAINFRAME					128
#define IDD_OPENGL_DIALOG		102
#define IDD_ABOUTBOX					103
#define IDS_APP_TITLE					103
#define IDM_ABOUT						104
#define IDM_EXIT						105
#define IDS_HELLO						106
#define IDI_OPENGL	            107
#define IDI_SMALL						108
#define IDC_OPENGL	            109
#define IDC_MYICON						2
#define IDC_STATIC	                    -1
// Next default values for new objects
// 
#ifdef APSTUDIO_INVOKED
#ifndef APSTUDIO_READONLY_SYMBOLS

#define _APS_NEXT_RESOURCE_VALUE        129
#define _APS_NEXT_COMMAND_VALUE         32771
#define _APS_NEXT_CONTROL_VALUE         1000
#define _APS_NEXT_SYMED_VALUE           110
#endif
#endif
