SimeonSimeonovIvanov/ROBKO-01/(commit log)

2016-12-30 ROBKO-01
    ROBKO-01
    [5 Star.brd, Copy of demo.brd, Robko_Test.brd, demo.brd, main.obj, v.0.0.0.brd, v.0.0.0.sch, v.0.0.1.brd]
2020-03-06 Add Power Backup 1&2 ckt&img
